puskyer/Fixture-Dev-Kit/HARDWARE/MOSFET-NOTE/P-ChannelMosfetCircuit.jpg

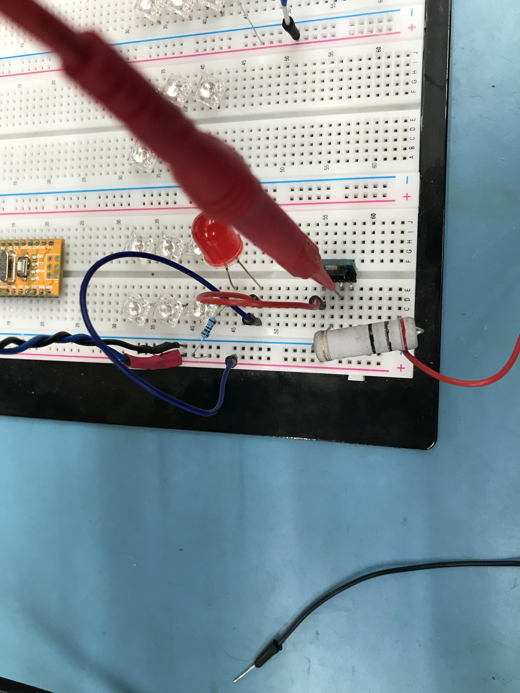
HARDWARE/MOSFET-NOTE/P-ChannelMosfetCircuit.jpg
