puskyer/Fixture-Dev-Kit/HARDWARE/MOSFET-NOTE/N-ChannelMosfetCircuit.jpg

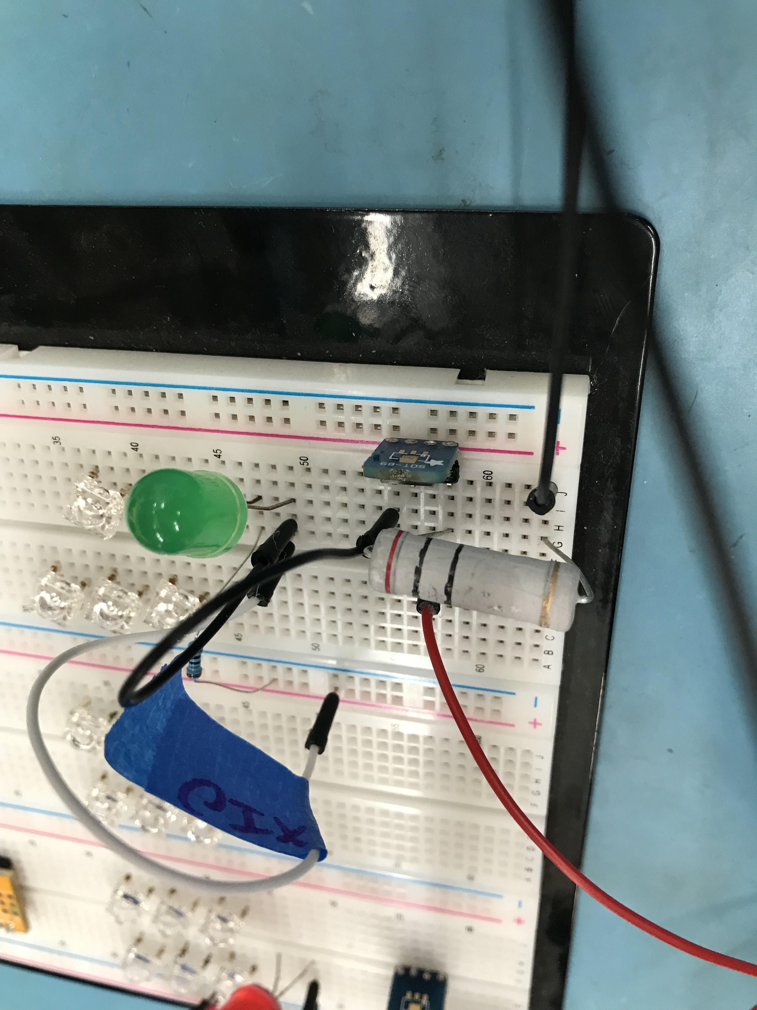
HARDWARE/MOSFET-NOTE/N-ChannelMosfetCircuit.jpg
