puskyer/Fixture-Dev-Kit/README.md

# Fixture-Dev-Kit
A PCB for test fixture prototyping
