puskyer/Fixture-Dev-Kit/HARDWARE/Fixture-Dev-Kit-v0.02/DATASHEETS/YSS-19-1202-N.jpg

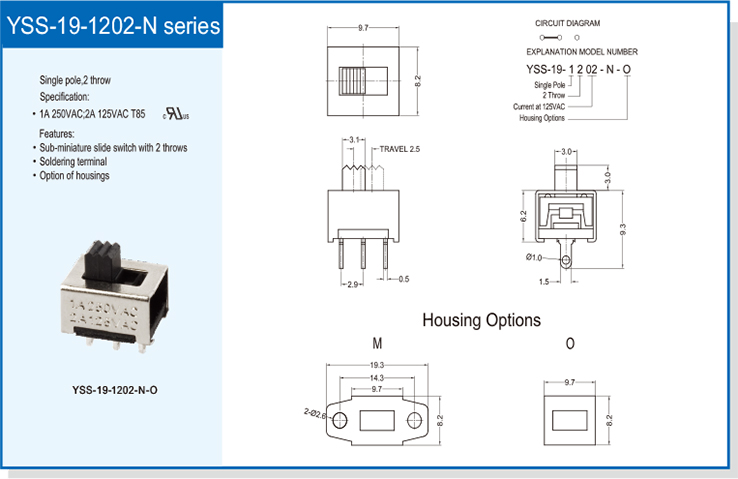
HARDWARE/Fixture-Dev-Kit-v0.02/DATASHEETS/YSS-19-1202-N.jpg
