puskyer/Fixture-Dev-Kit/HARDWARE/MOSFET-NOTE/MOSFET-P+N-Circuits.jpg

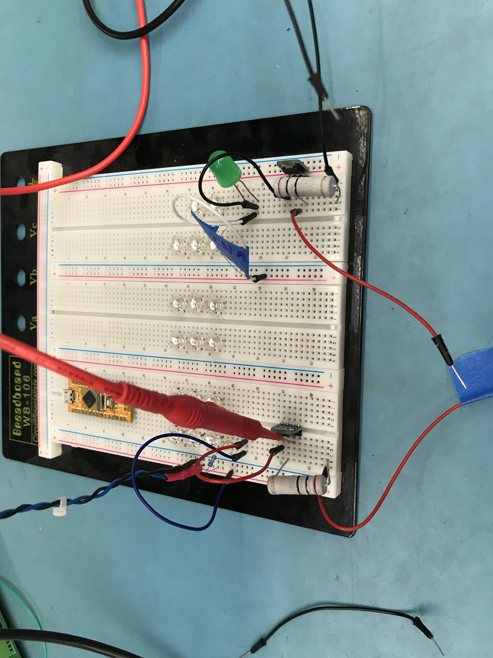
HARDWARE/MOSFET-NOTE/MOSFET-P+N-Circuits.jpg
