puskyer/Fixture-Dev-Kit/HARDWARE/CHIP4_DUT_Adapter_Board_PCB/Fixture-Dev-Kit-C4-Adapater-Board.SLDPRT

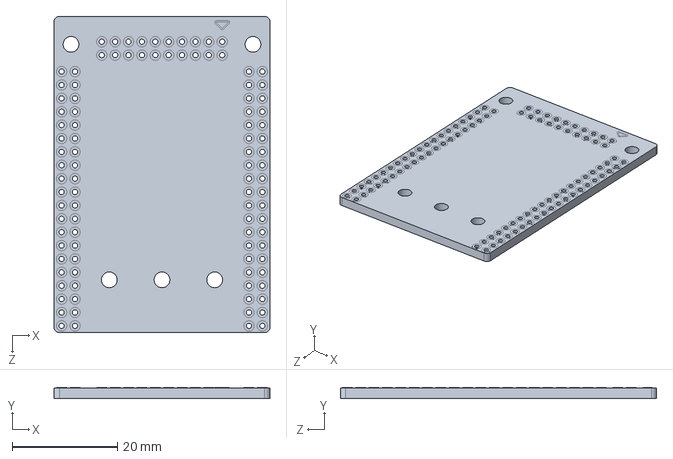
[picture p8: CAD file, 2017-11-10]
HARDWARE/CHIP4_DUT_Adapter_Board_PCB/Fixture-Dev-Kit-C4-Adapater-Board.SLDPRT
41.0 x 2.01 x 60.0 mm
