puskyer/Fixture-Dev-Kit/HARDWARE/CHIP4_DUT_Adapter_Board_PCB/KiCad/v0.02/Fixture-Dev-Kit-C4-Adapater-Board-PCB/3d_models/PUQFN-N32_5mmX5mm_P0.5.step

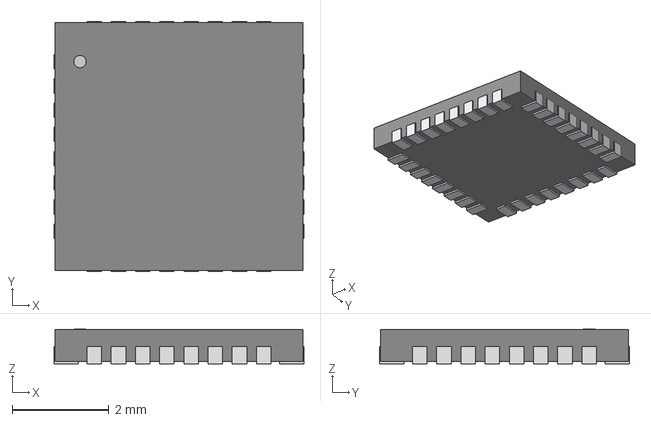
[picture p9: CAD file, 2017-11-21]
HARDWARE/CHIP4_DUT_Adapter_Board_PCB/KiCad/v0.02/Fixture-Dev-Kit-C4-Adapater-Board-PCB/3d_models/PUQFN-N32_5mmX5mm_P0.5.step
5.16 x 5.16 x 0.714 mm
