puskyer/Fixture-Dev-Kit/(list of files, cad)

Other CAD files:
HARDWARE/CHIP4_DUT_Adapter_Board_PCB/Fixture-Dev-Kit-C4-Adapater-Board.SLDDRW
