puskyer/Fixture-Dev-Kit/HARDWARE/CHIP4_DUT_Adapter_Board_PCB/KiCad/v0.02/Fixture-Dev-Kit-C4-Adapater-Board-PCB/pdf/Fixture-Dev-Kit-C4-Adapater-Board.PDF

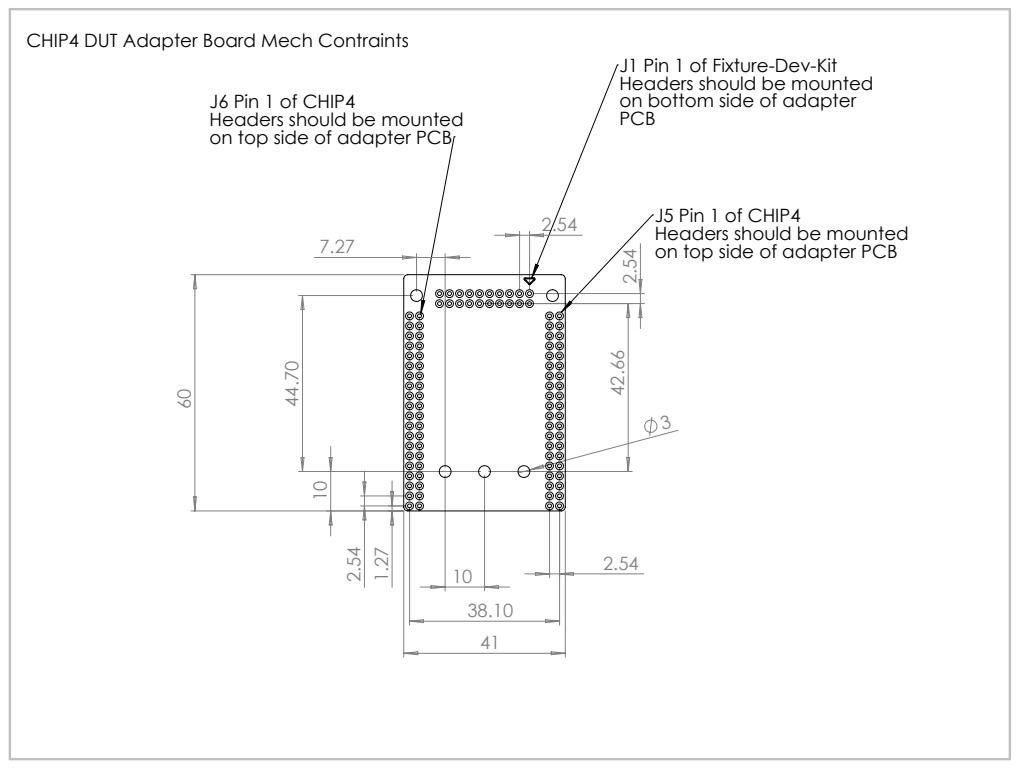
[picture p10: page 1]

CHIP4 DUT Adapter Board Mech Contraints

J1 Pin 1 of Fixture-Dev-Kit
Headers should be mounted
on bottom side of adapter
PCB

J6 Pin 1 of CHIP4
on top side of adapter PCB

J5 Pin 1 of CHIP4
