puskyer/Fixture-Dev-Kit/HARDWARE/MOSFET-NOTE/file5A05F538-Sheet5A05F538.pdf

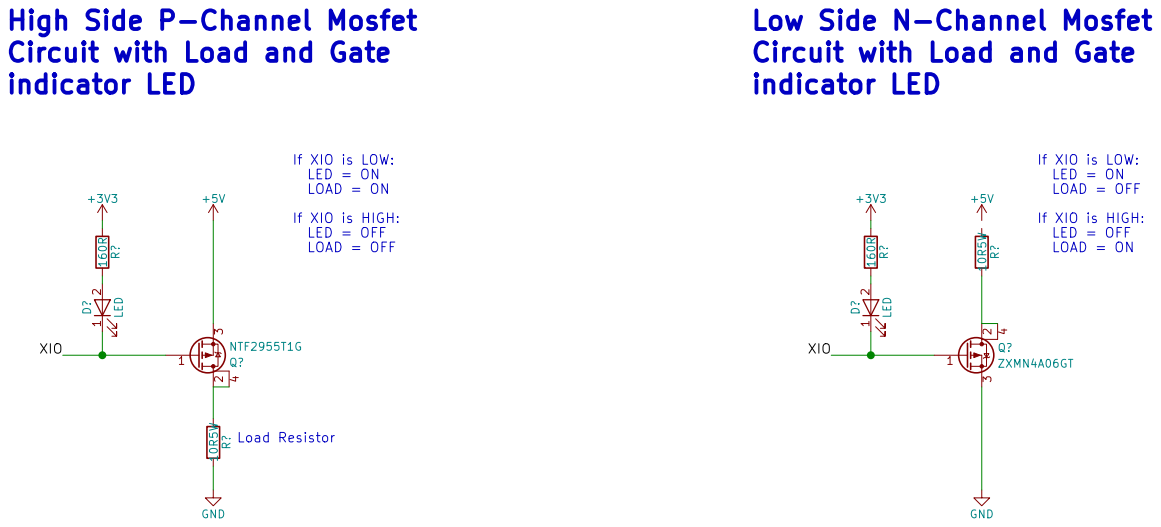
[picture p11: page 1]
