puskyer/Fixture-Dev-Kit/HARDWARE/v0.05/KiCad/pdf/Bottom_Cu_Layers.pdf

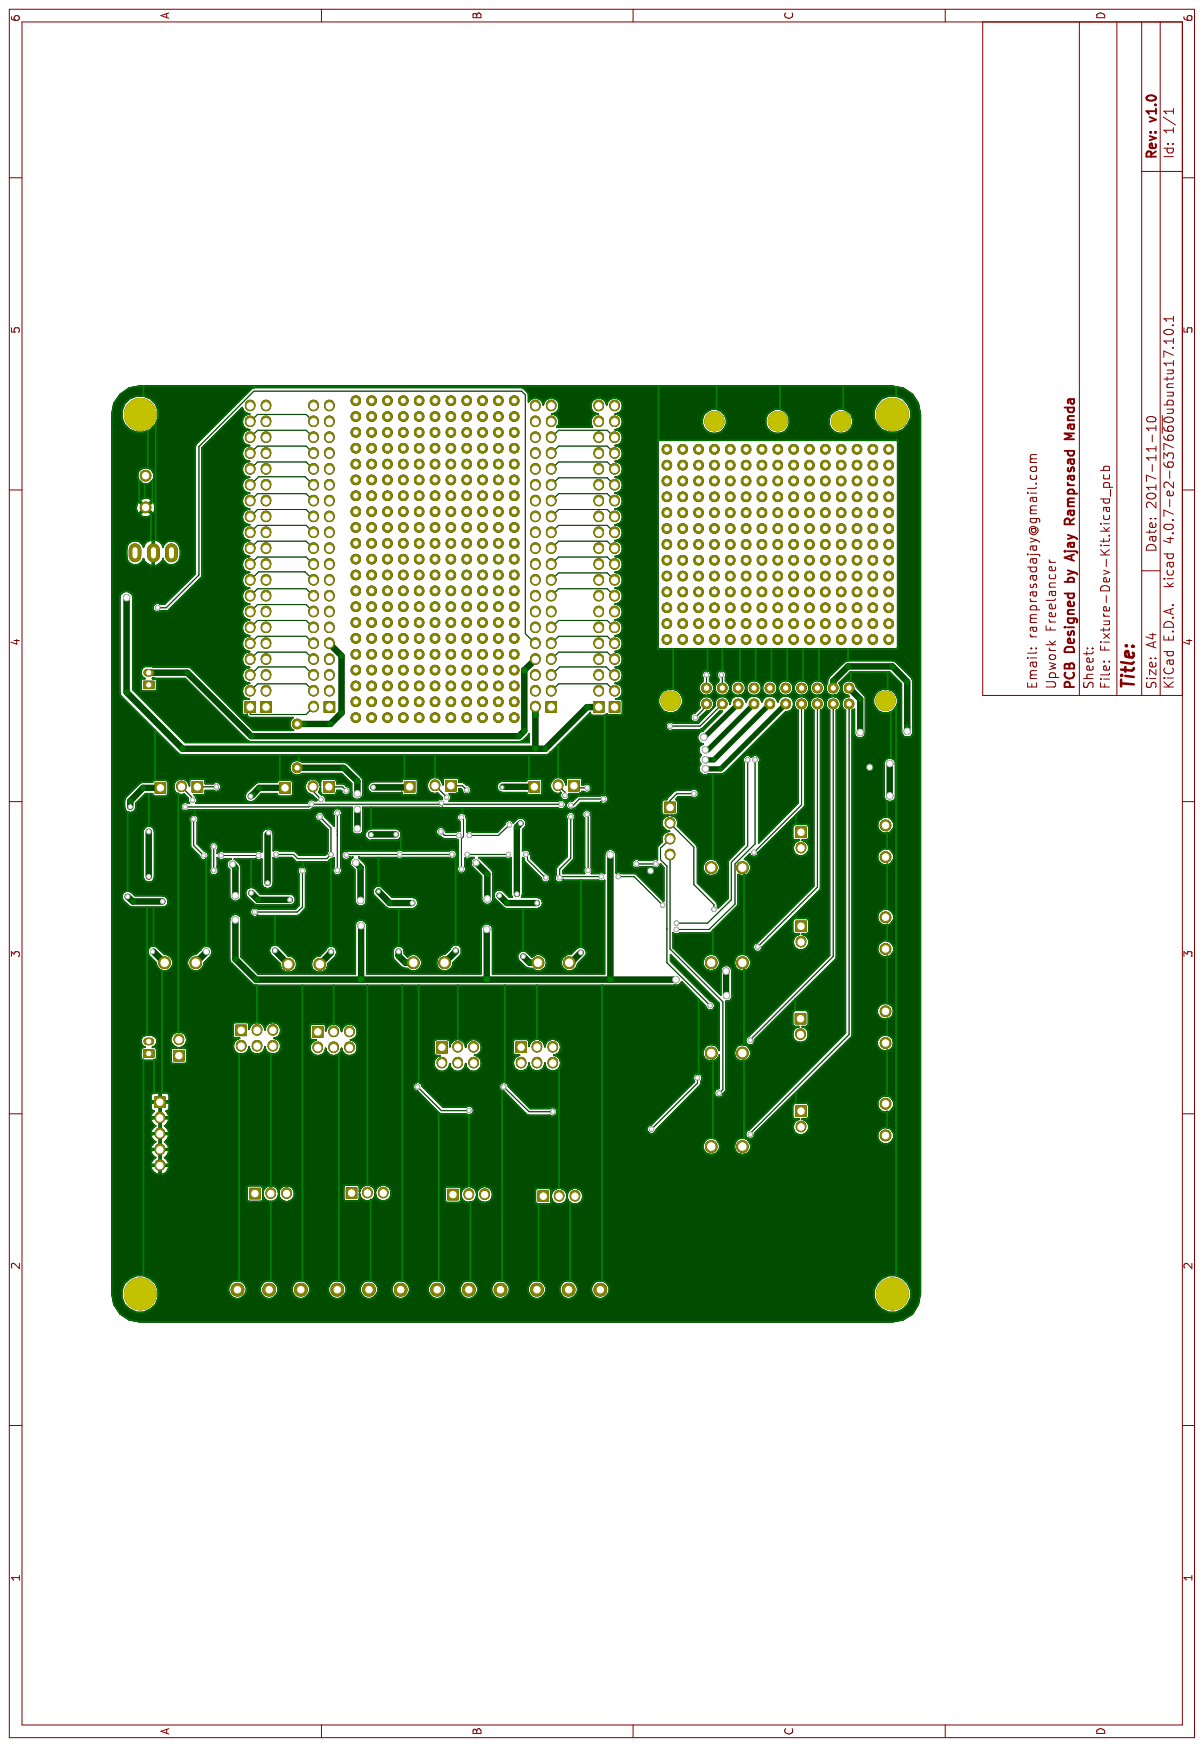
[picture p12: page 1]

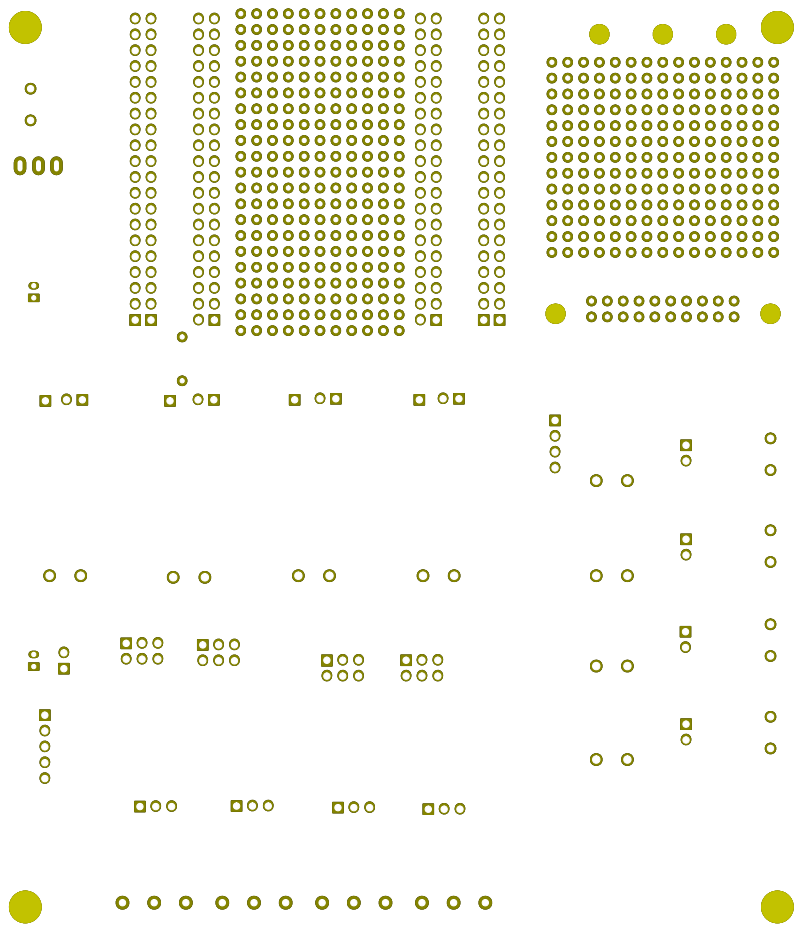
[picture p13: page 2]

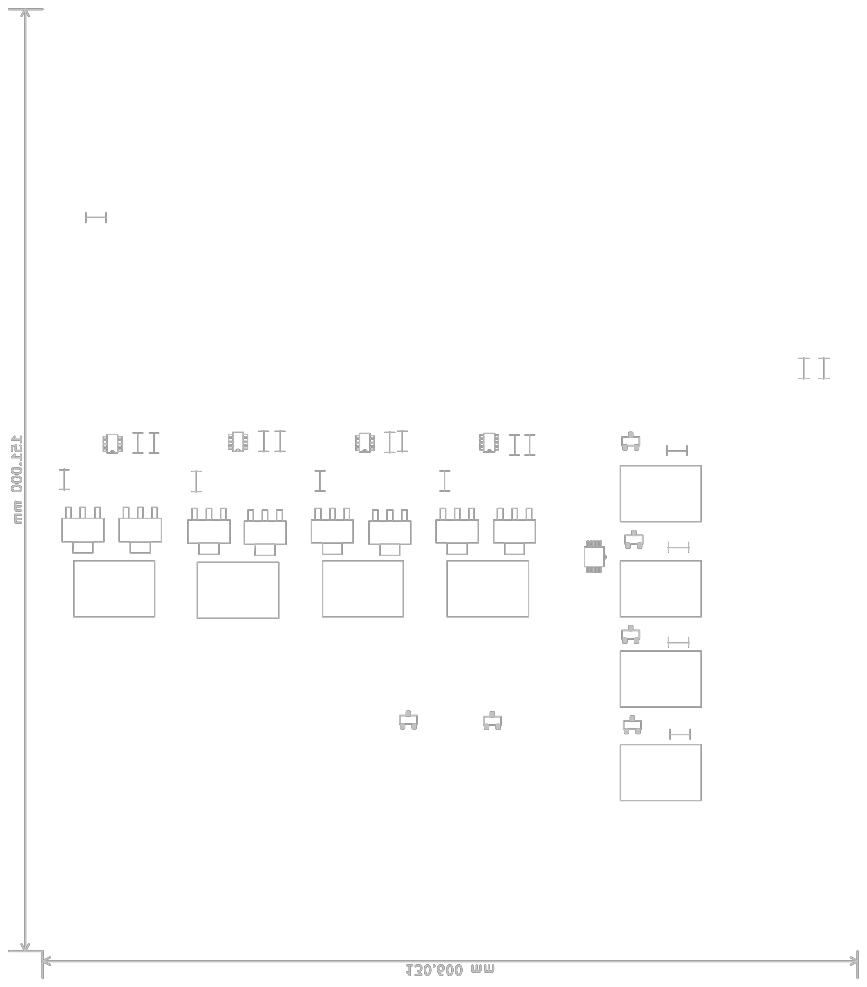
[picture p14: page 3]

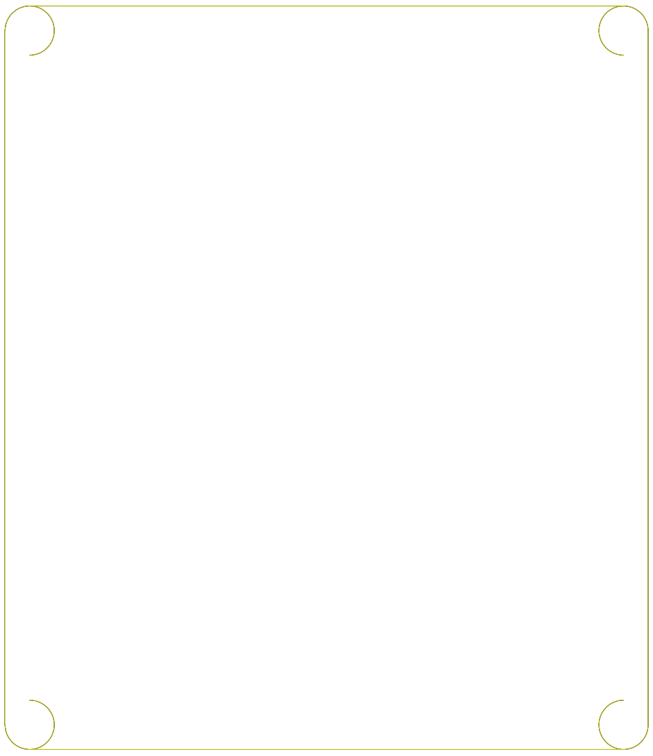
[picture p15: figure]
