puskyer/Fixture-Dev-Kit/HARDWARE/v0.05/KiCad/pdf/Front_Cu_Layers.pdf

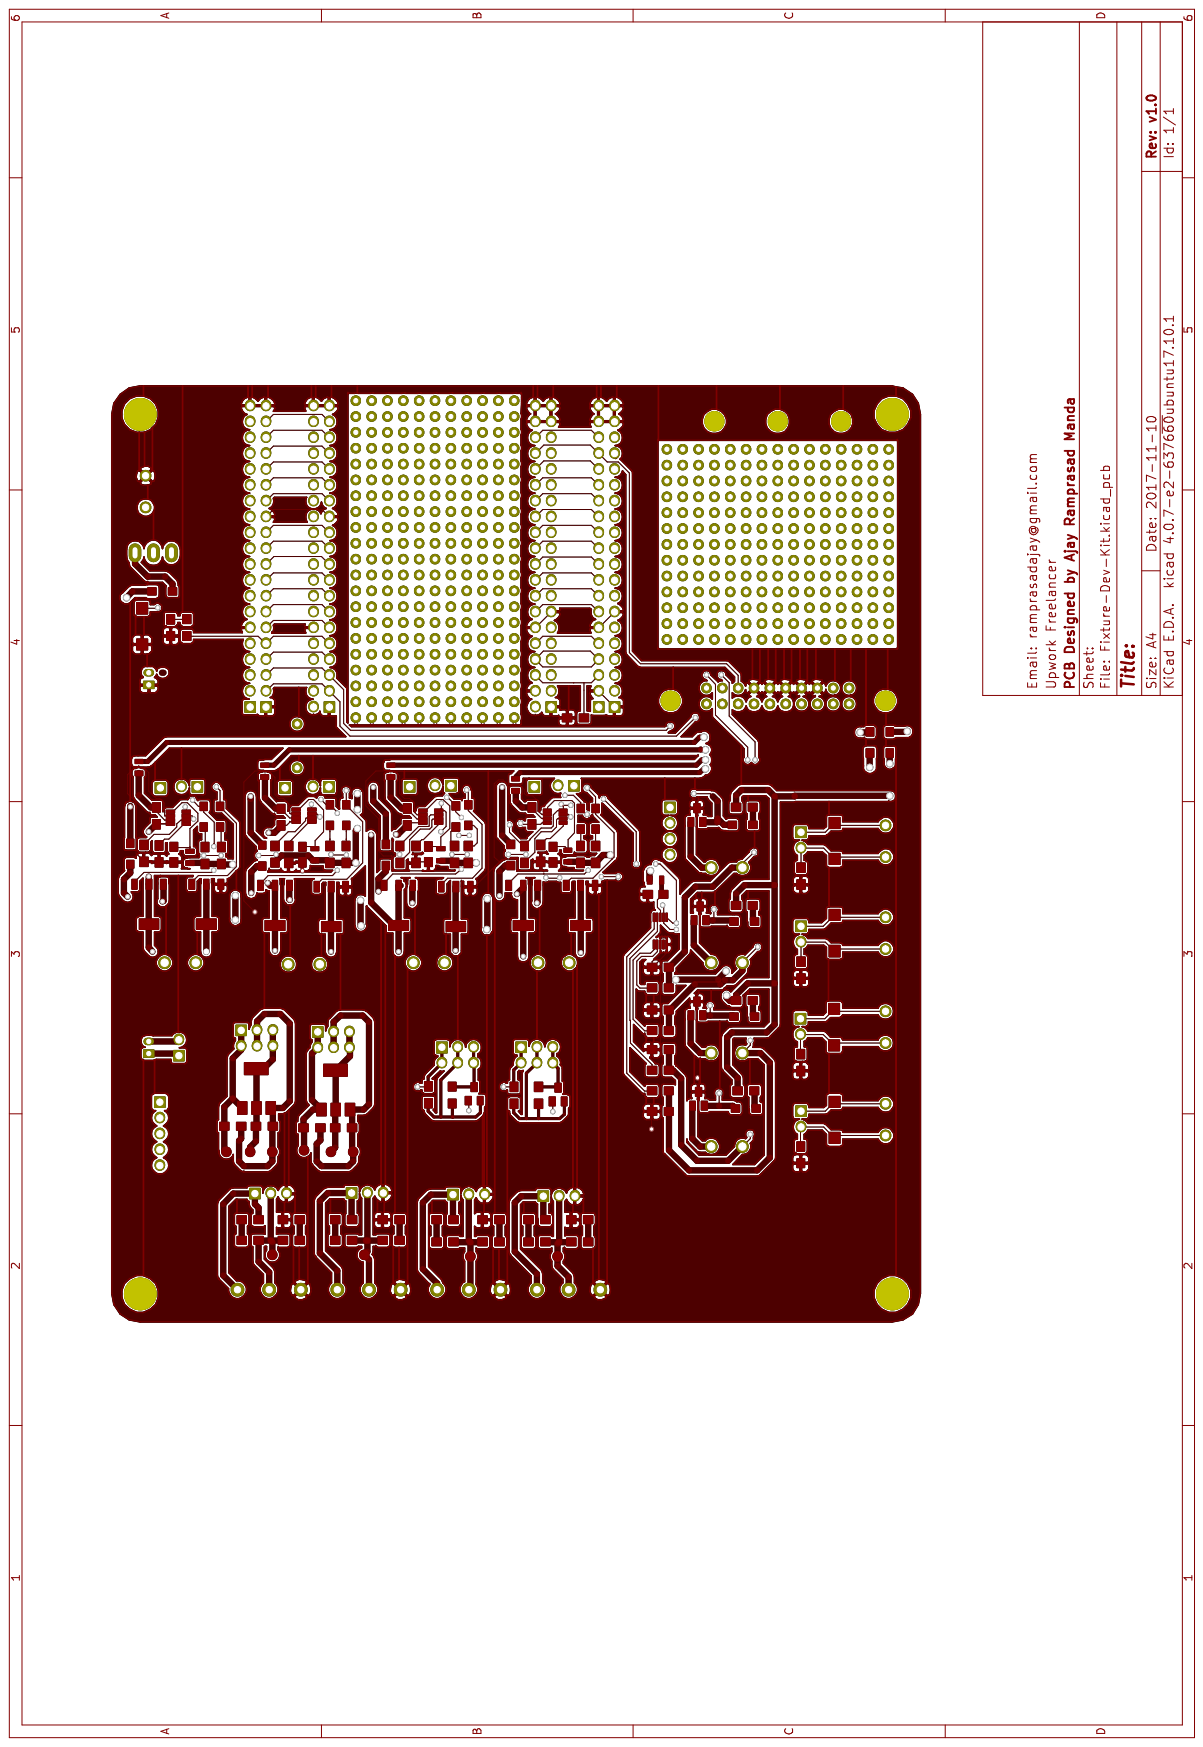
[picture p16: page 1]

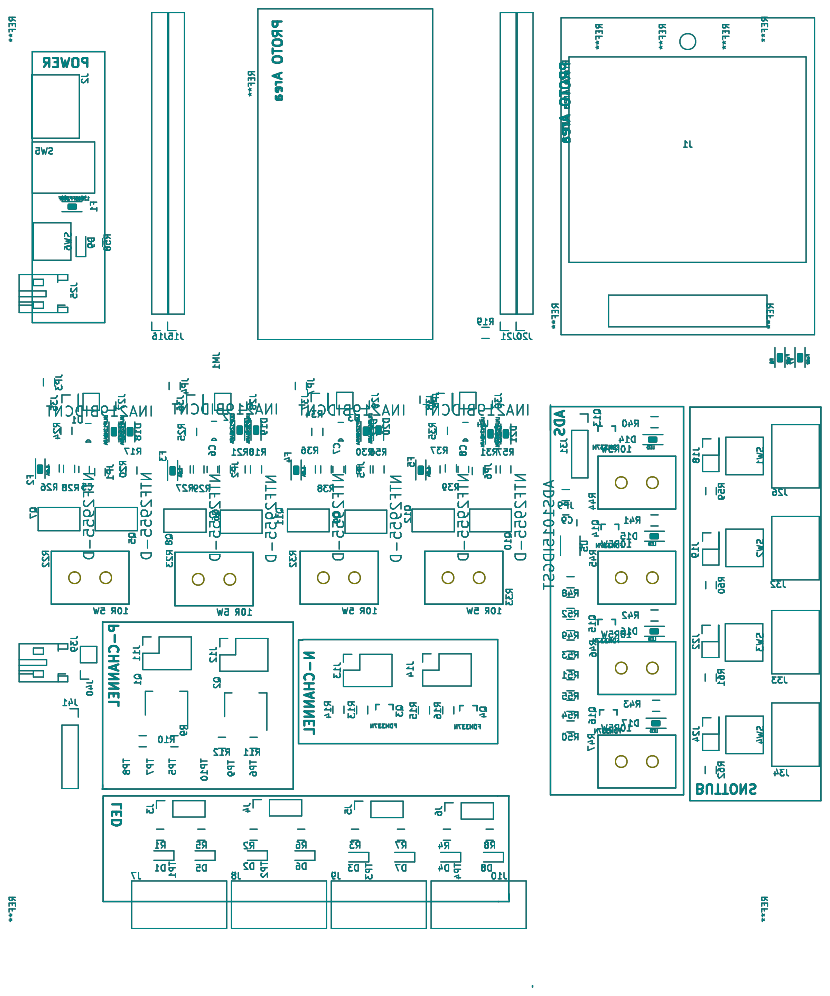
[picture p17: page 2]

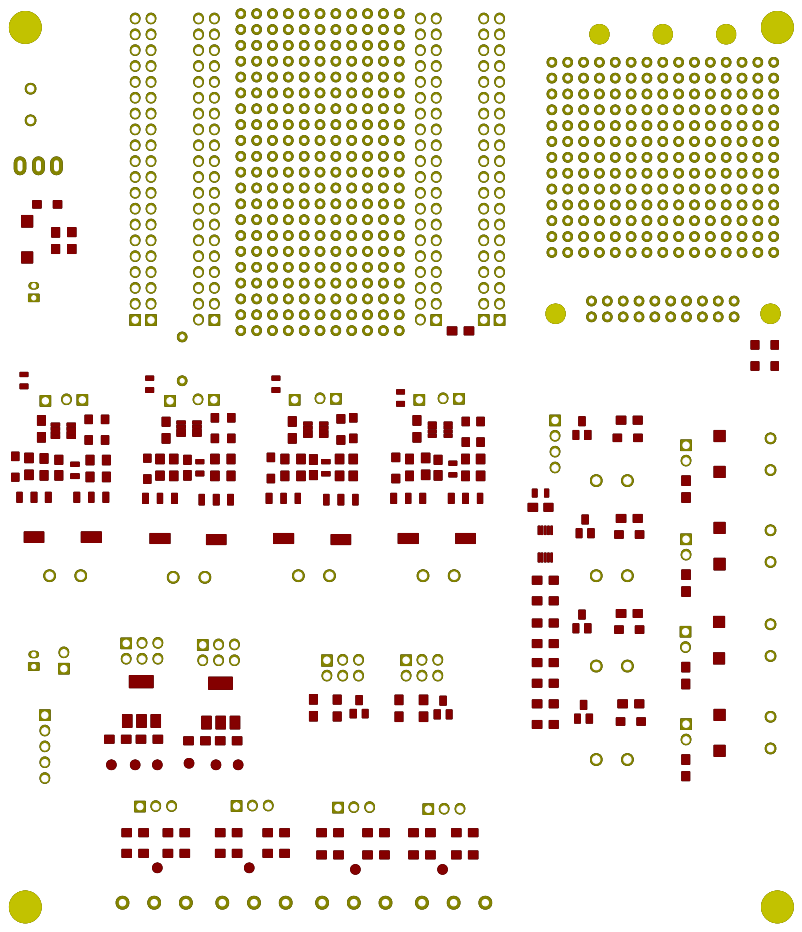
[picture p18: page 3]


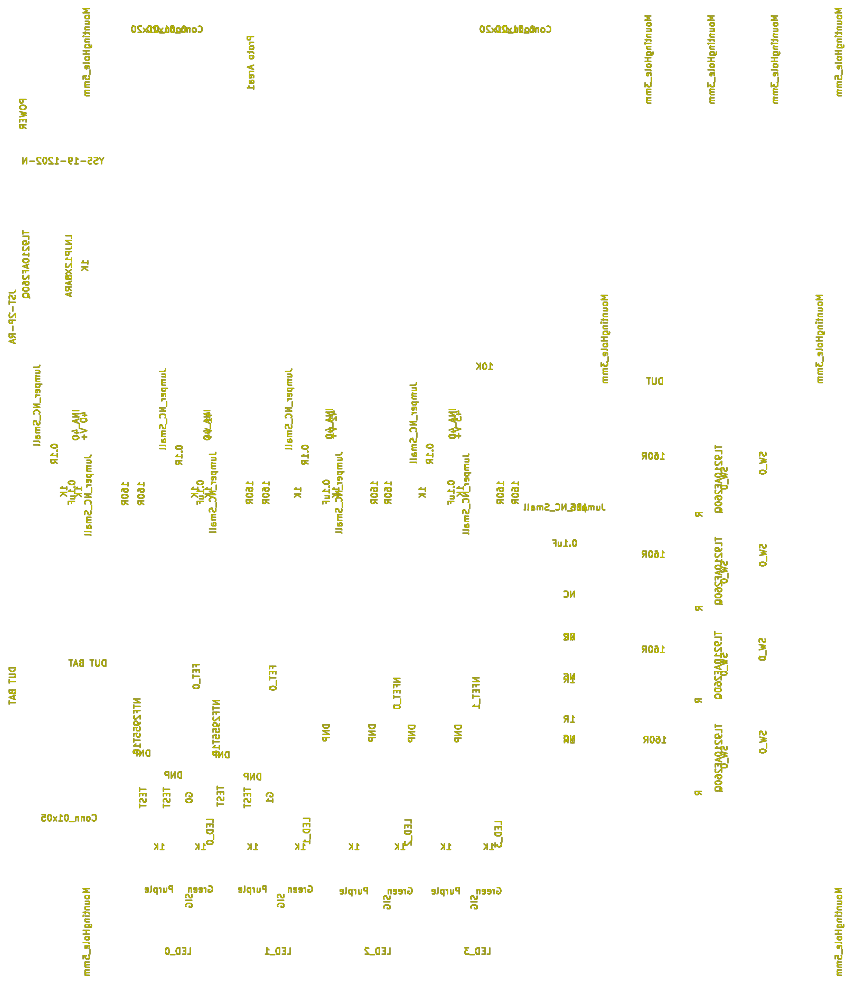
[picture p19: page 6]
