puskyer/Fixture-Dev-Kit/HARDWARE/v0.02/KiCad/Gerber/Fixture-Dev-Kit-B.Cu.pdf

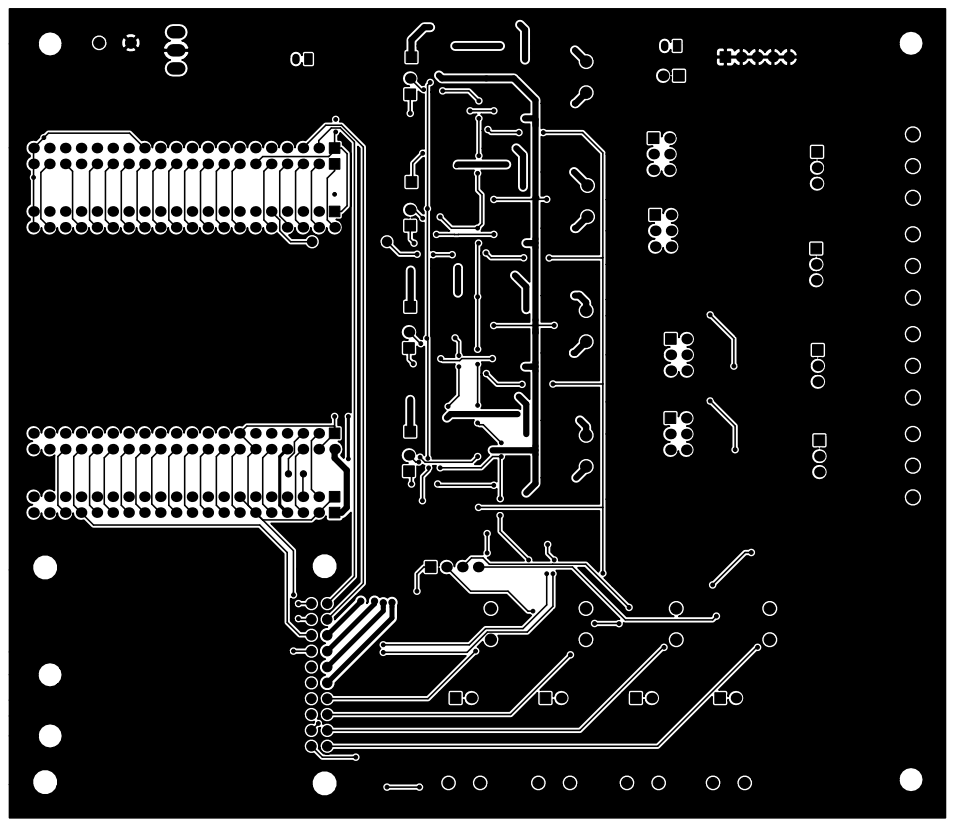
[picture p30: page 1]
