puskyer/Fixture-Dev-Kit/HARDWARE/v0.02/KiCad/Gerber/Fixture-Dev-Kit-Edge.Cuts.pdf

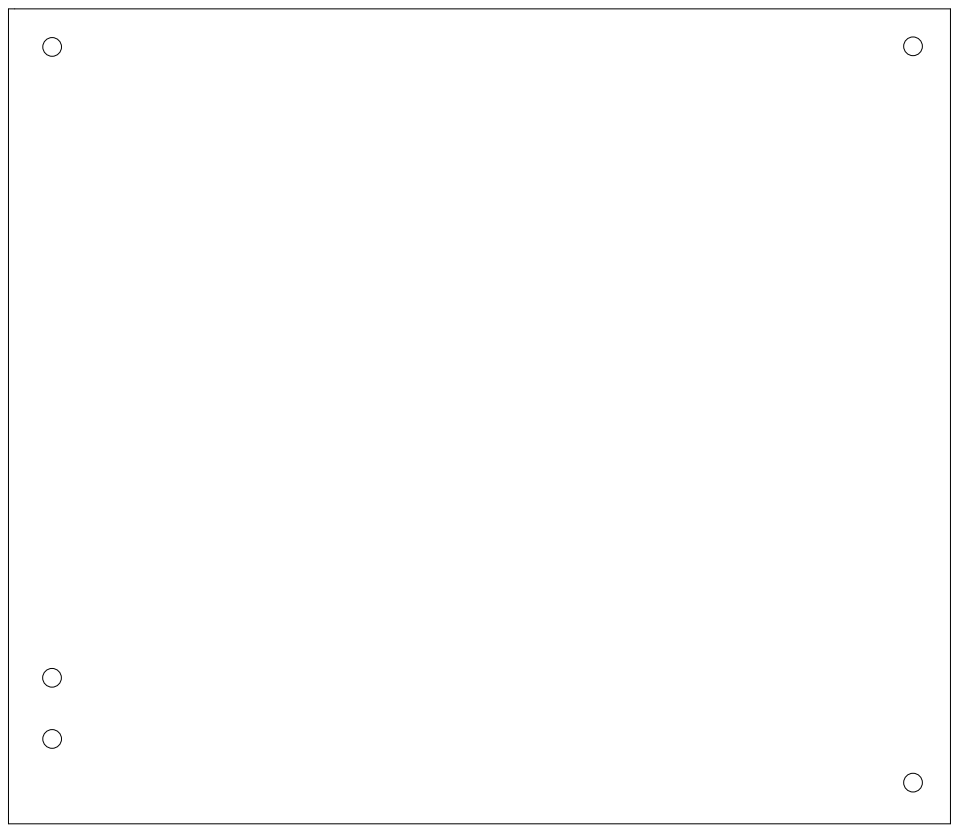
[picture p31: page 1]
