puskyer/Fixture-Dev-Kit/HARDWARE/v0.02/KiCad/Gerber/Fixture-Dev-Kit-F.Cu.pdf

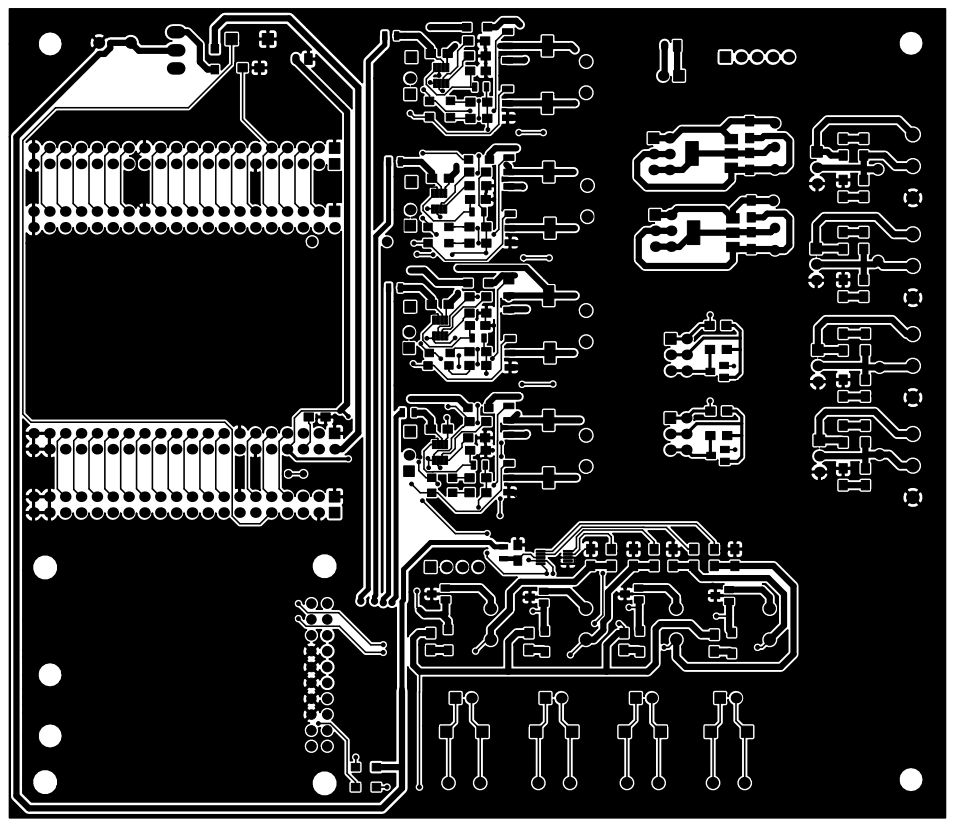
[picture p32: page 1]
