puskyer/Fixture-Dev-Kit/HARDWARE/v0.02/KiCad/Gerber/Fixture-Dev-Kit-F.Mask.pdf

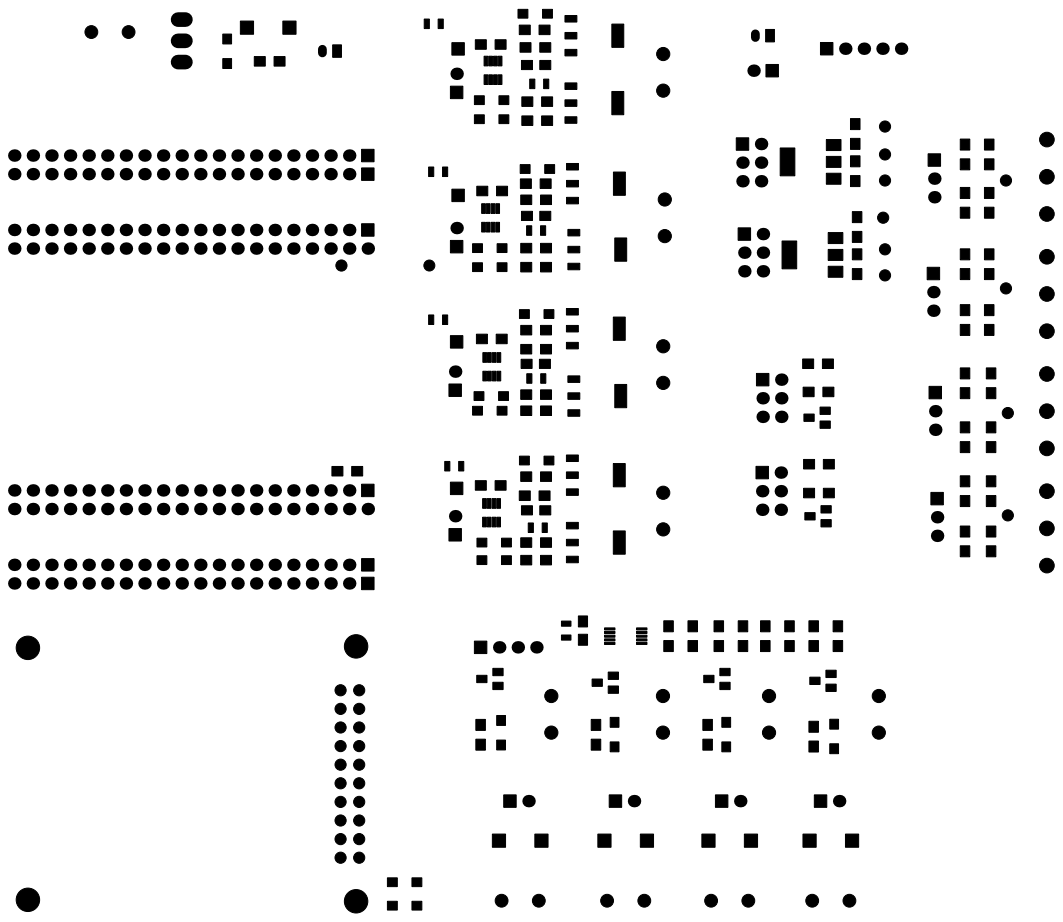
[picture p33: page 1]
