puskyer/Fixture-Dev-Kit/HARDWARE/v0.02/KiCad/Gerber/Fixture-Dev-Kit-F.Paste.pdf

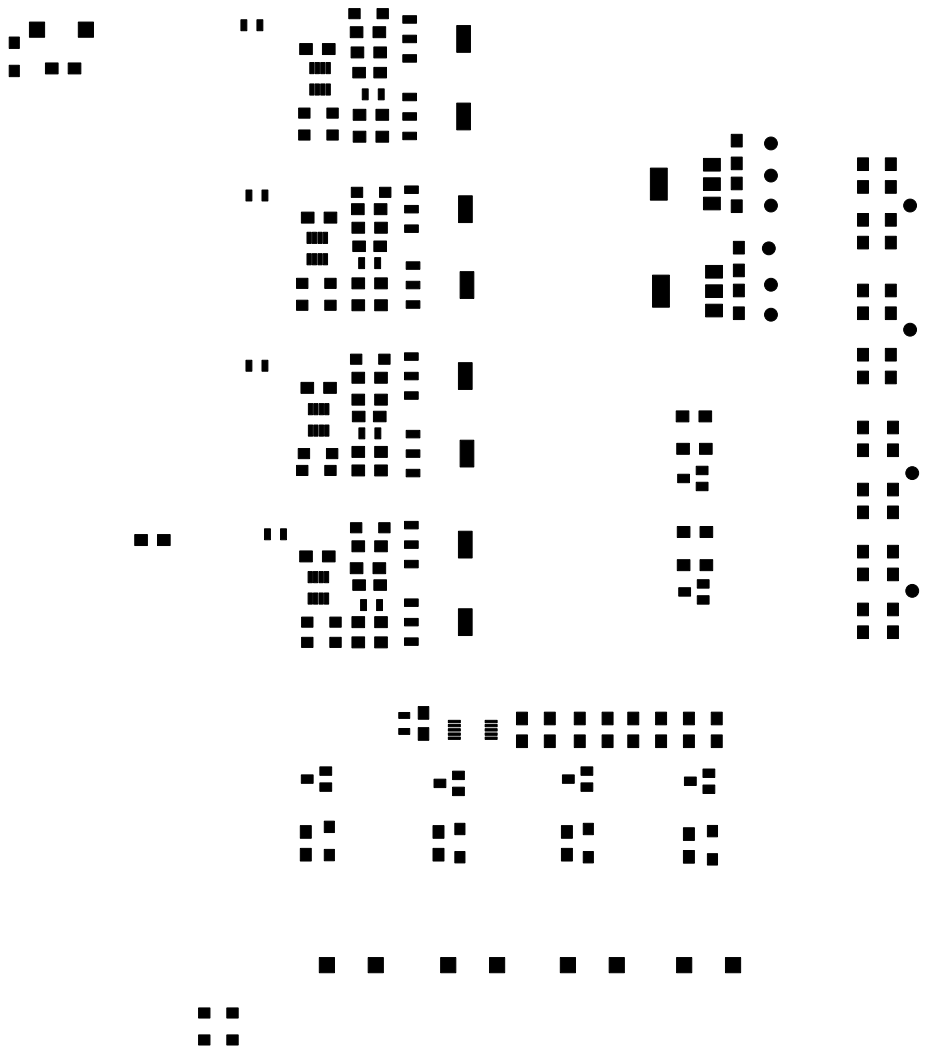
[picture p34: page 1]
