puskyer/Fixture-Dev-Kit/HARDWARE/v0.04/KiCad/Fixture-Dev-Kit.kicad_pcb

## KiCad design HARDWARE/v0.04/KiCad/Fixture-Dev-Kit.kicad_pcb (2017-11-10, an earlier design)

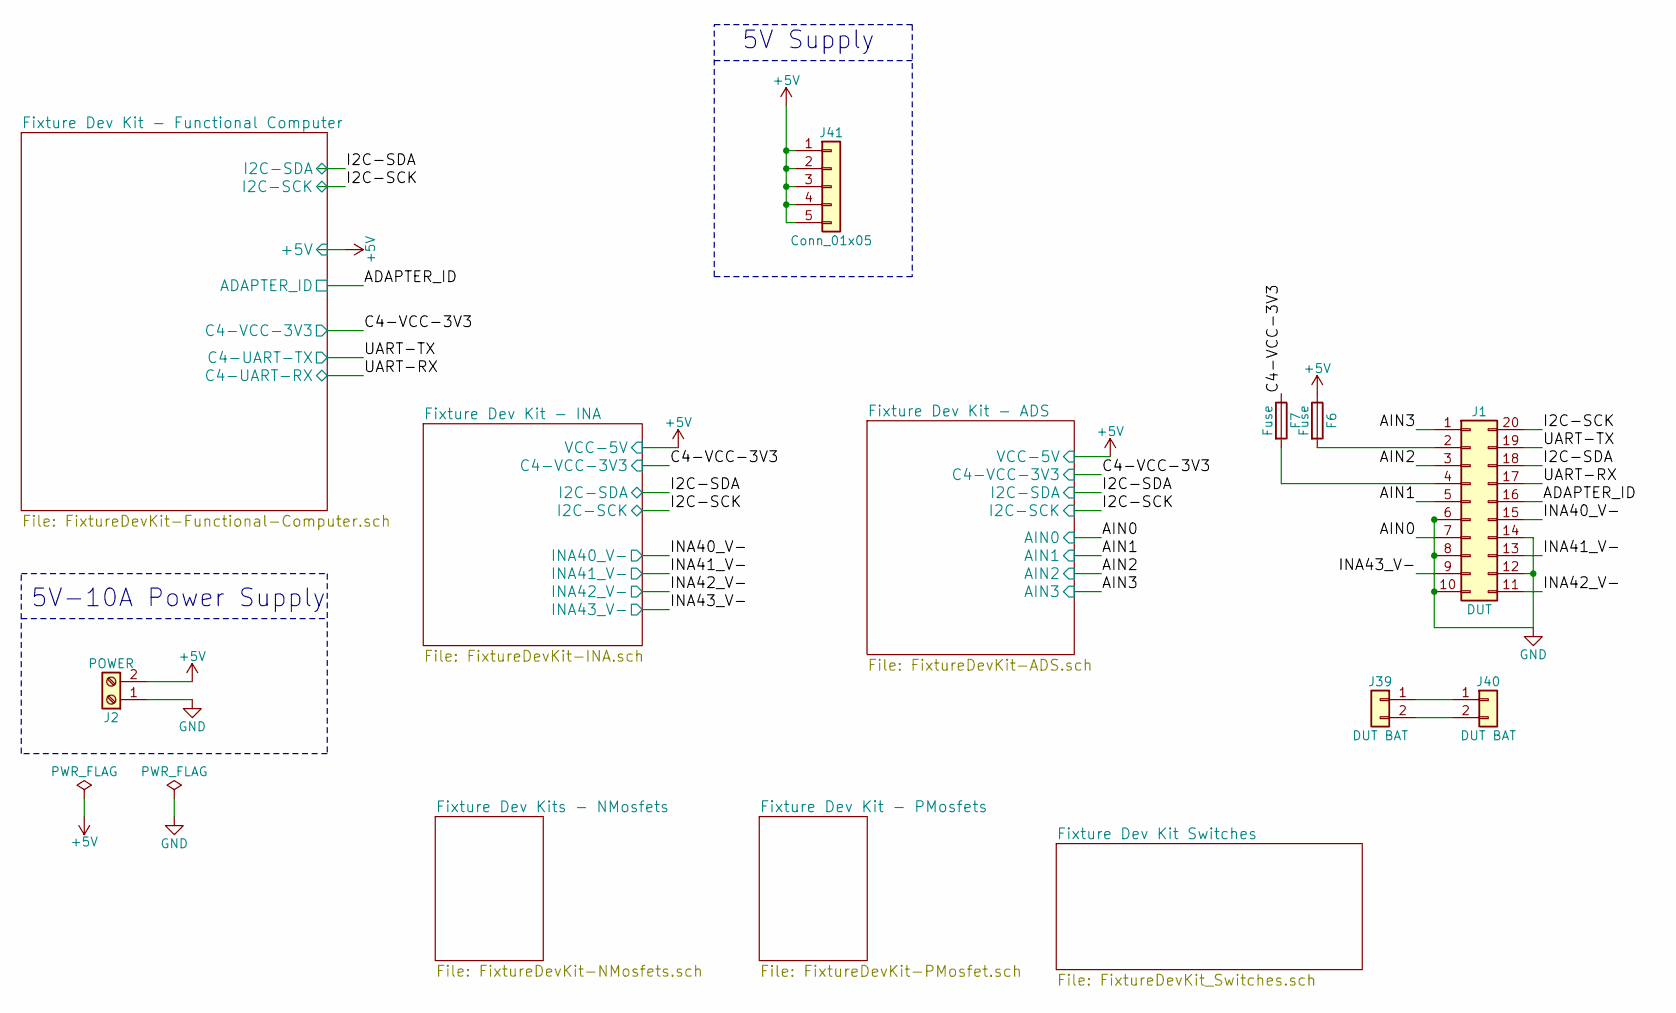
[picture p36: schematic Fixture-Dev-Kit.sch]

Parts:
F6, F7: Fuse; 1206
J1: DUT; DUT_HEADER_FOOTPRINT
J2: POWER; 2Pin5.08
J39: DUT BAT; JST_PH_S2B-PH-K_02x2.00mm_Angled
J40: DUT BAT; Pin_Header_Straight_1x02_Pitch2.54mm
J41: Conn_01x05; Pin_Header_Angled_1x05_Pitch2.54mm

Connections:
+5V: F6.1, J2.2, J41.1, J41.2, J41.3, J41.4, J41.5; also elsewhere on the board
/ADAPTER_ID: J1.16; also elsewhere on the board
/AIN0: J1.7; also elsewhere on the board
/AIN1: J1.5; also elsewhere on the board
/AIN2: J1.3; also elsewhere on the board
/AIN3: J1.1; also elsewhere on the board
/C4-VCC-3V3: F7.1; also elsewhere on the board
/I2C-SCK: J1.20; also elsewhere on the board
/I2C-SDA: J1.18; also elsewhere on the board
/INA40_V-: J1.15; also elsewhere on the board
/INA41_V-: J1.13; also elsewhere on the board
/INA42_V-: J1.11; also elsewhere on the board
/INA43_V-: J1.9; also elsewhere on the board
/UART-RX: J1.17; also elsewhere on the board
/UART-TX: J1.19; also elsewhere on the board
unnamed: F6.2, J1.2
unnamed: F7.2, J1.4
unnamed: J39.1, J40.1
unnamed: J39.2, J40.2

Notes on the sheet:
5V-10A Power Supply
5V Supply

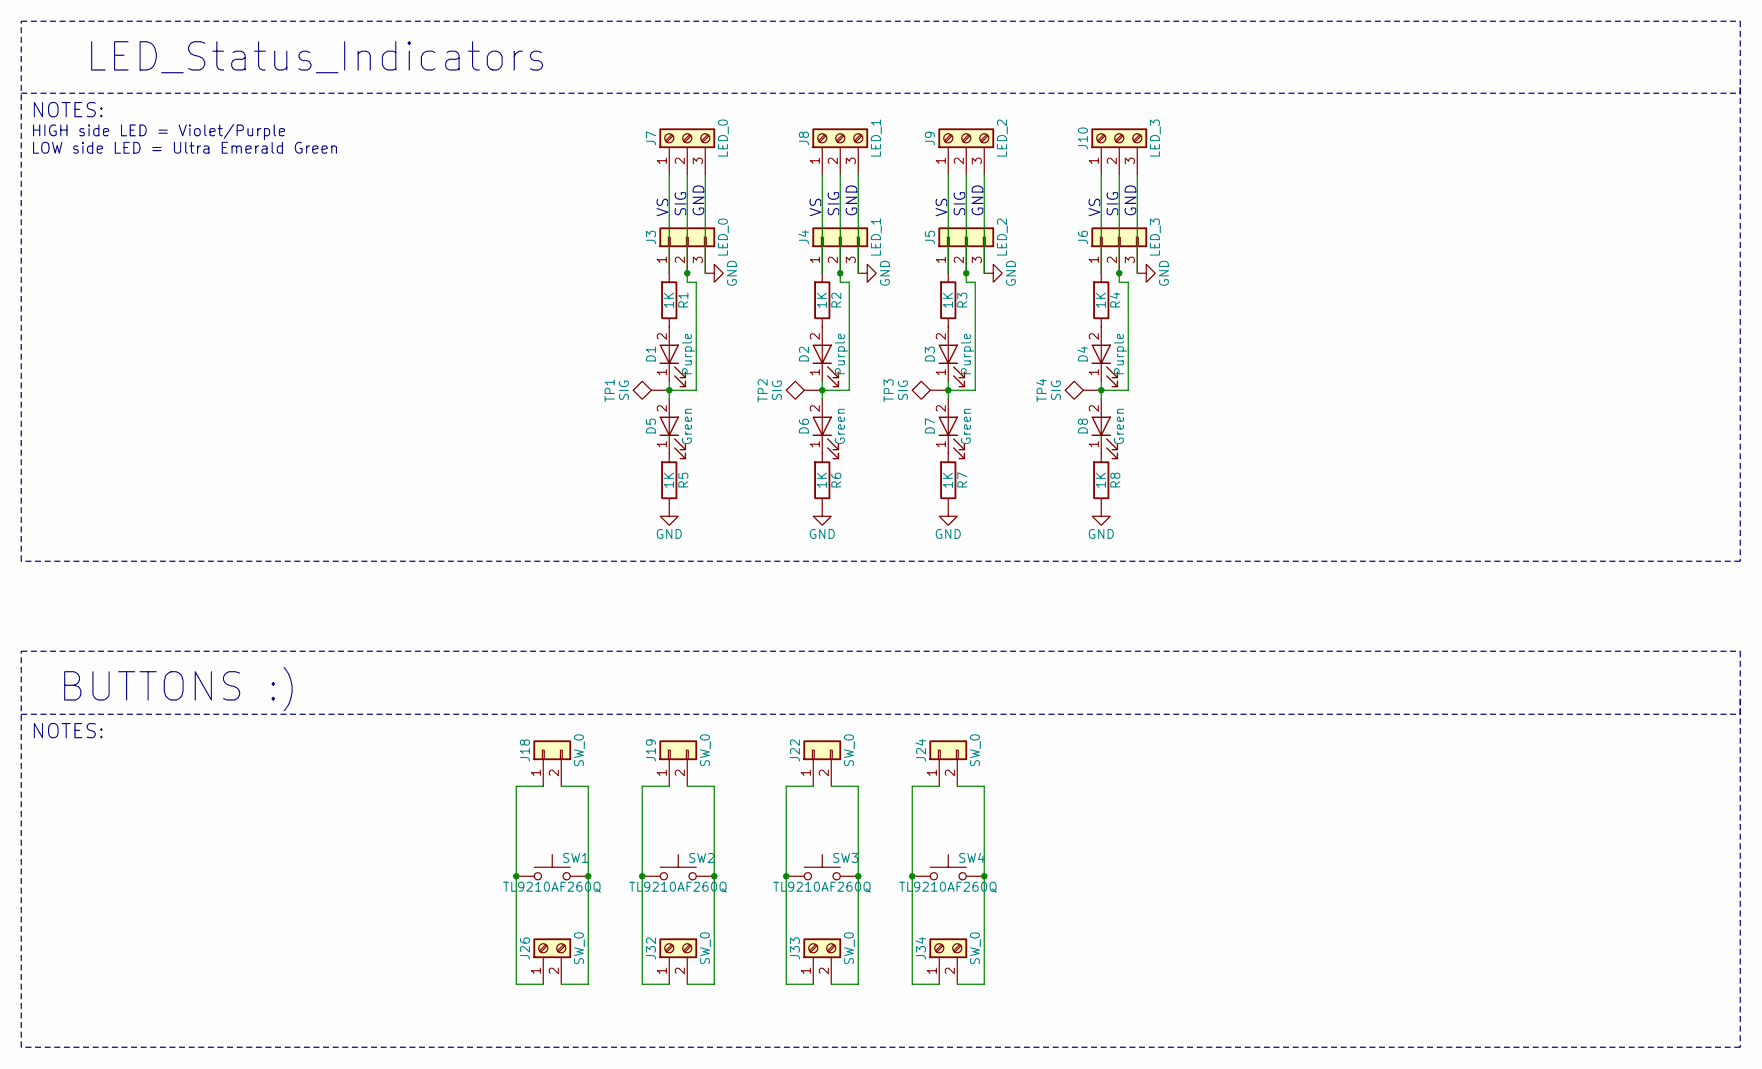
[picture p37: schematic FixtureDevKit_Switches.sch, Fixture-Dev-Kit]

Parts:
D1, D2, D3, D4: Purple; LED_0805_HandSoldering
D5, D6, D7, D8: Green; LED_0805_HandSoldering
J3: LED_0; Pin_Header_Straight_1x03_Pitch2.54mm
J4: LED_1; Pin_Header_Straight_1x03_Pitch2.54mm
J5: LED_2; Pin_Header_Straight_1x03_Pitch2.54mm
J6: LED_3; Pin_Header_Straight_1x03_Pitch2.54mm
J7: LED_0; 3Pin5.08
J8: LED_1; 3Pin5.08
J9: LED_2; 3Pin5.08
J10: LED_3; 3Pin5.08
J18, J19, J22, J24: SW_0; Pin_Header_Straight_2x01_Pitch2.54mm
J26, J32, J33, J34: SW_0; 2Pin5.08
R1, R2, R3, R4, R5, R6, R7, R8: 1K; R_0805_HandSoldering
SW1, SW2, SW3, SW4: TL9210AF260Q
TP1, TP2, TP3, TP4: SIG; TestPoint

Connections:
unnamed: D1.1 (K), D5.2 (A), J3.2, J7.2, TP1.1
unnamed: D1.2 (A), R1.1
unnamed: D2.1 (K), D6.2 (A), J4.2, J8.2, TP2.1
unnamed: D2.2 (A), R2.1
unnamed: D3.1 (K), D7.2 (A), J5.2, J9.2, TP3.1
unnamed: D3.2 (A), R3.1
unnamed: D4.1 (K), D8.2 (A), J6.2, J10.2, TP4.1
unnamed: D4.2 (A), R4.1
unnamed: D5.1 (K), R5.2
unnamed: D6.1 (K), R6.2
unnamed: D7.1 (K), R7.2
unnamed: D8.1 (K), R8.2
unnamed: J3.1, J7.1, R1.2
unnamed: J4.1, J8.1, R2.2
unnamed: J5.1, J9.1, R3.2
unnamed: J6.1, J10.1, R4.2
unnamed: J18.1, J26.1, SW1.1
unnamed: J18.2, J26.2, SW1.2
unnamed: J19.1, J32.1, SW2.1
unnamed: J19.2, J32.2, SW2.2
unnamed: J22.1, J33.1, SW3.1
unnamed: J22.2, J33.2, SW3.2
unnamed: J24.1, J34.1, SW4.1
unnamed: J24.2, J34.2, SW4.2

Notes on the sheet:
GND
SIG
LED_Status_Indicators
BUTTONS :)
HIGH side LED = Violet/Purple LOW side LED = Ultra Emerald Green
NOTES:

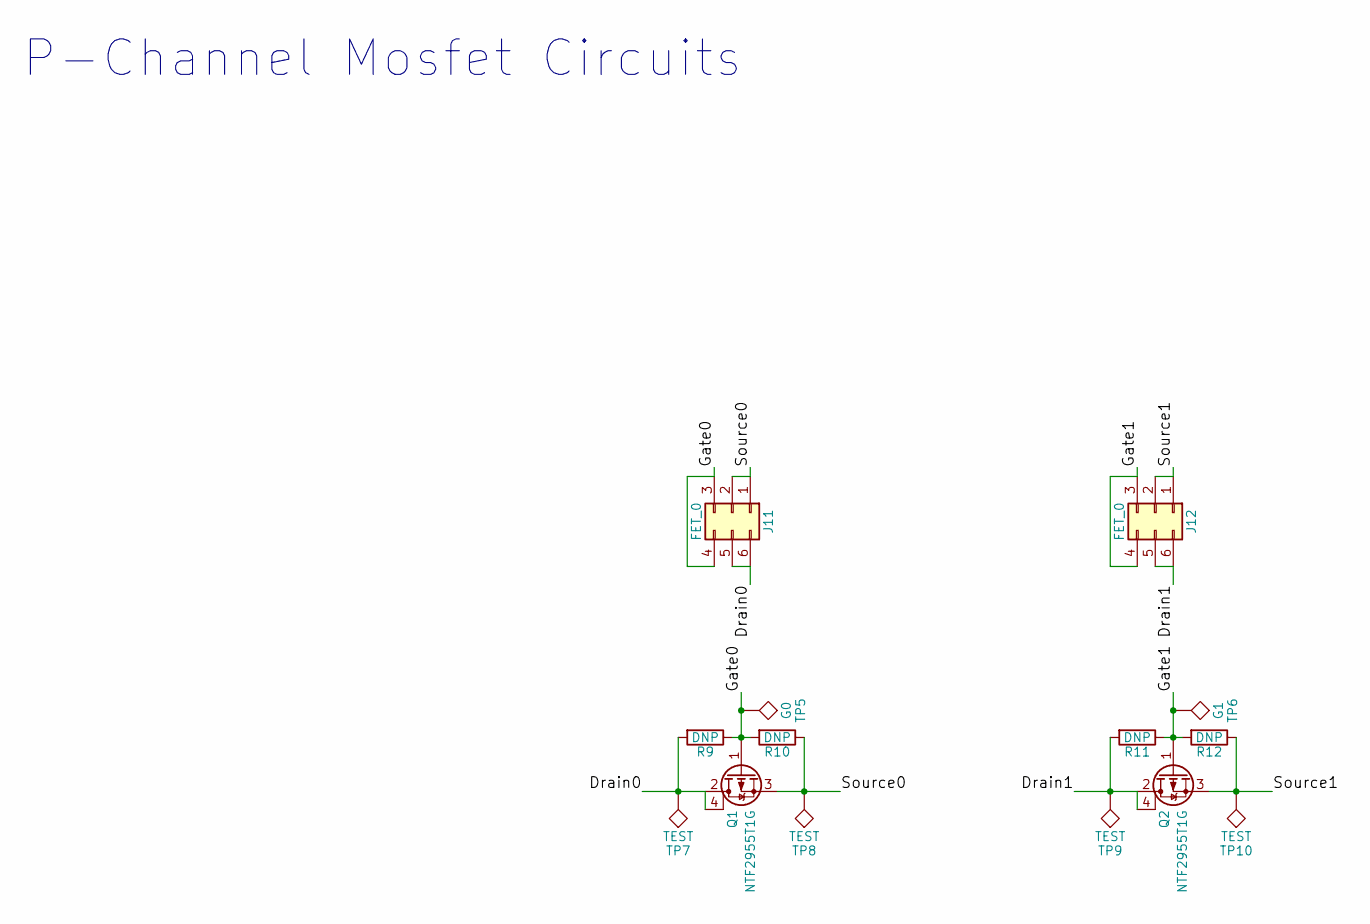
[picture p38: schematic FixtureDevKit-PMosfet.sch, Fixture-Dev-Kit]

Parts:
J11, J12: FET_0; Pin_Header_Straight_2x03_Pitch2.54mm
Q1, Q2: NTF2955T1G; SOT-223
R9, R10, R11, R12: DNP; R_0805_HandSoldering
TP5: G0; TestPoint
TP6: G1; TestPoint
TP7, TP8, TP9, TP10: TEST; TestPoint

Connections:
/Fixture Dev Kit - PMosfets/Drain0: J11.5, J11.6, Q1.2 (D), Q1.4 (D), R9.2, TP7.1
/Fixture Dev Kit - PMosfets/Drain1: J12.5, J12.6, Q2.2 (D), Q2.4 (D), R11.2, TP9.1
/Fixture Dev Kit - PMosfets/Gate0: J11.3, J11.4, Q1.1 (G), R9.1, R10.2, TP5.1
/Fixture Dev Kit - PMosfets/Gate1: J12.3, J12.4, Q2.1 (G), R11.1, R12.2, TP6.1
/Fixture Dev Kit - PMosfets/Source0: J11.1, J11.2, Q1.3 (S), R10.1, TP8.1
/Fixture Dev Kit - PMosfets/Source1: J12.1, J12.2, Q2.3 (S), R12.1, TP10.1

Notes on the sheet:
P-Channel Mosfet Circuits

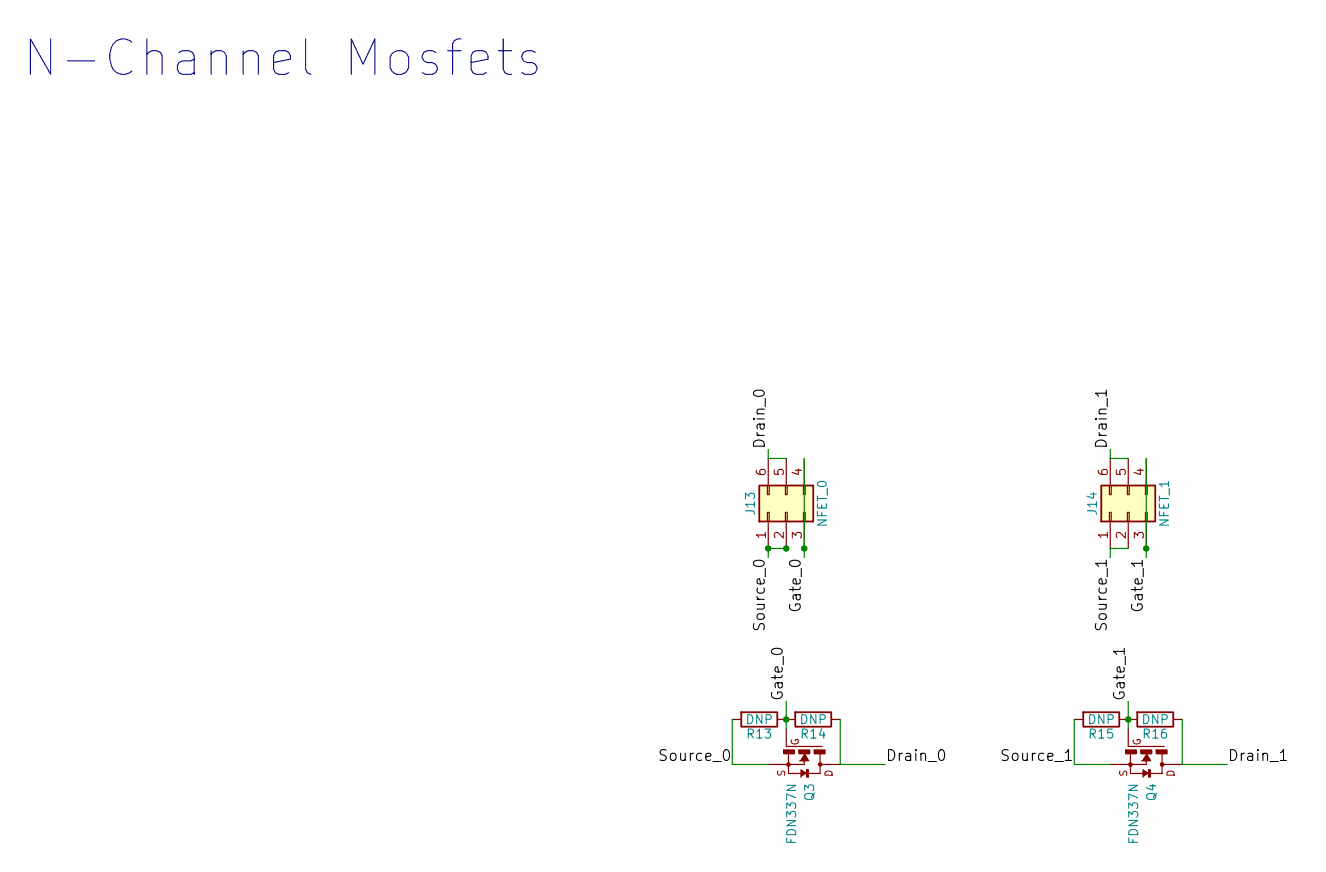
[picture p39: schematic FixtureDevKit-NMosfets.sch, Fixture-Dev-Kit]

Parts:
J13: NFET_0; Pin_Header_Straight_2x03_Pitch2.54mm
J14: NFET_1; Pin_Header_Straight_2x03_Pitch2.54mm
Q3, Q4: FDN337N; SSOT-3
R13, R14, R15, R16: DNP; R_0805_HandSoldering

Connections:
/Fixture Dev Kits - NMosfets/Drain_0: J13.5, J13.6, Q3.3 (D), R14.1
/Fixture Dev Kits - NMosfets/Drain_1: J14.5, J14.6, Q4.3 (D), R16.1
/Fixture Dev Kits - NMosfets/Gate_0: J13.3, J13.4, Q3.1 (G), R13.1, R14.2
/Fixture Dev Kits - NMosfets/Gate_1: J14.3, J14.4, Q4.1 (G), R15.1, R16.2
/Fixture Dev Kits - NMosfets/Source_0: J13.1, J13.2, Q3.2 (S), R13.2
/Fixture Dev Kits - NMosfets/Source_1: J14.1, J14.2, Q4.2 (S), R15.2

Notes on the sheet:
N-Channel Mosfets

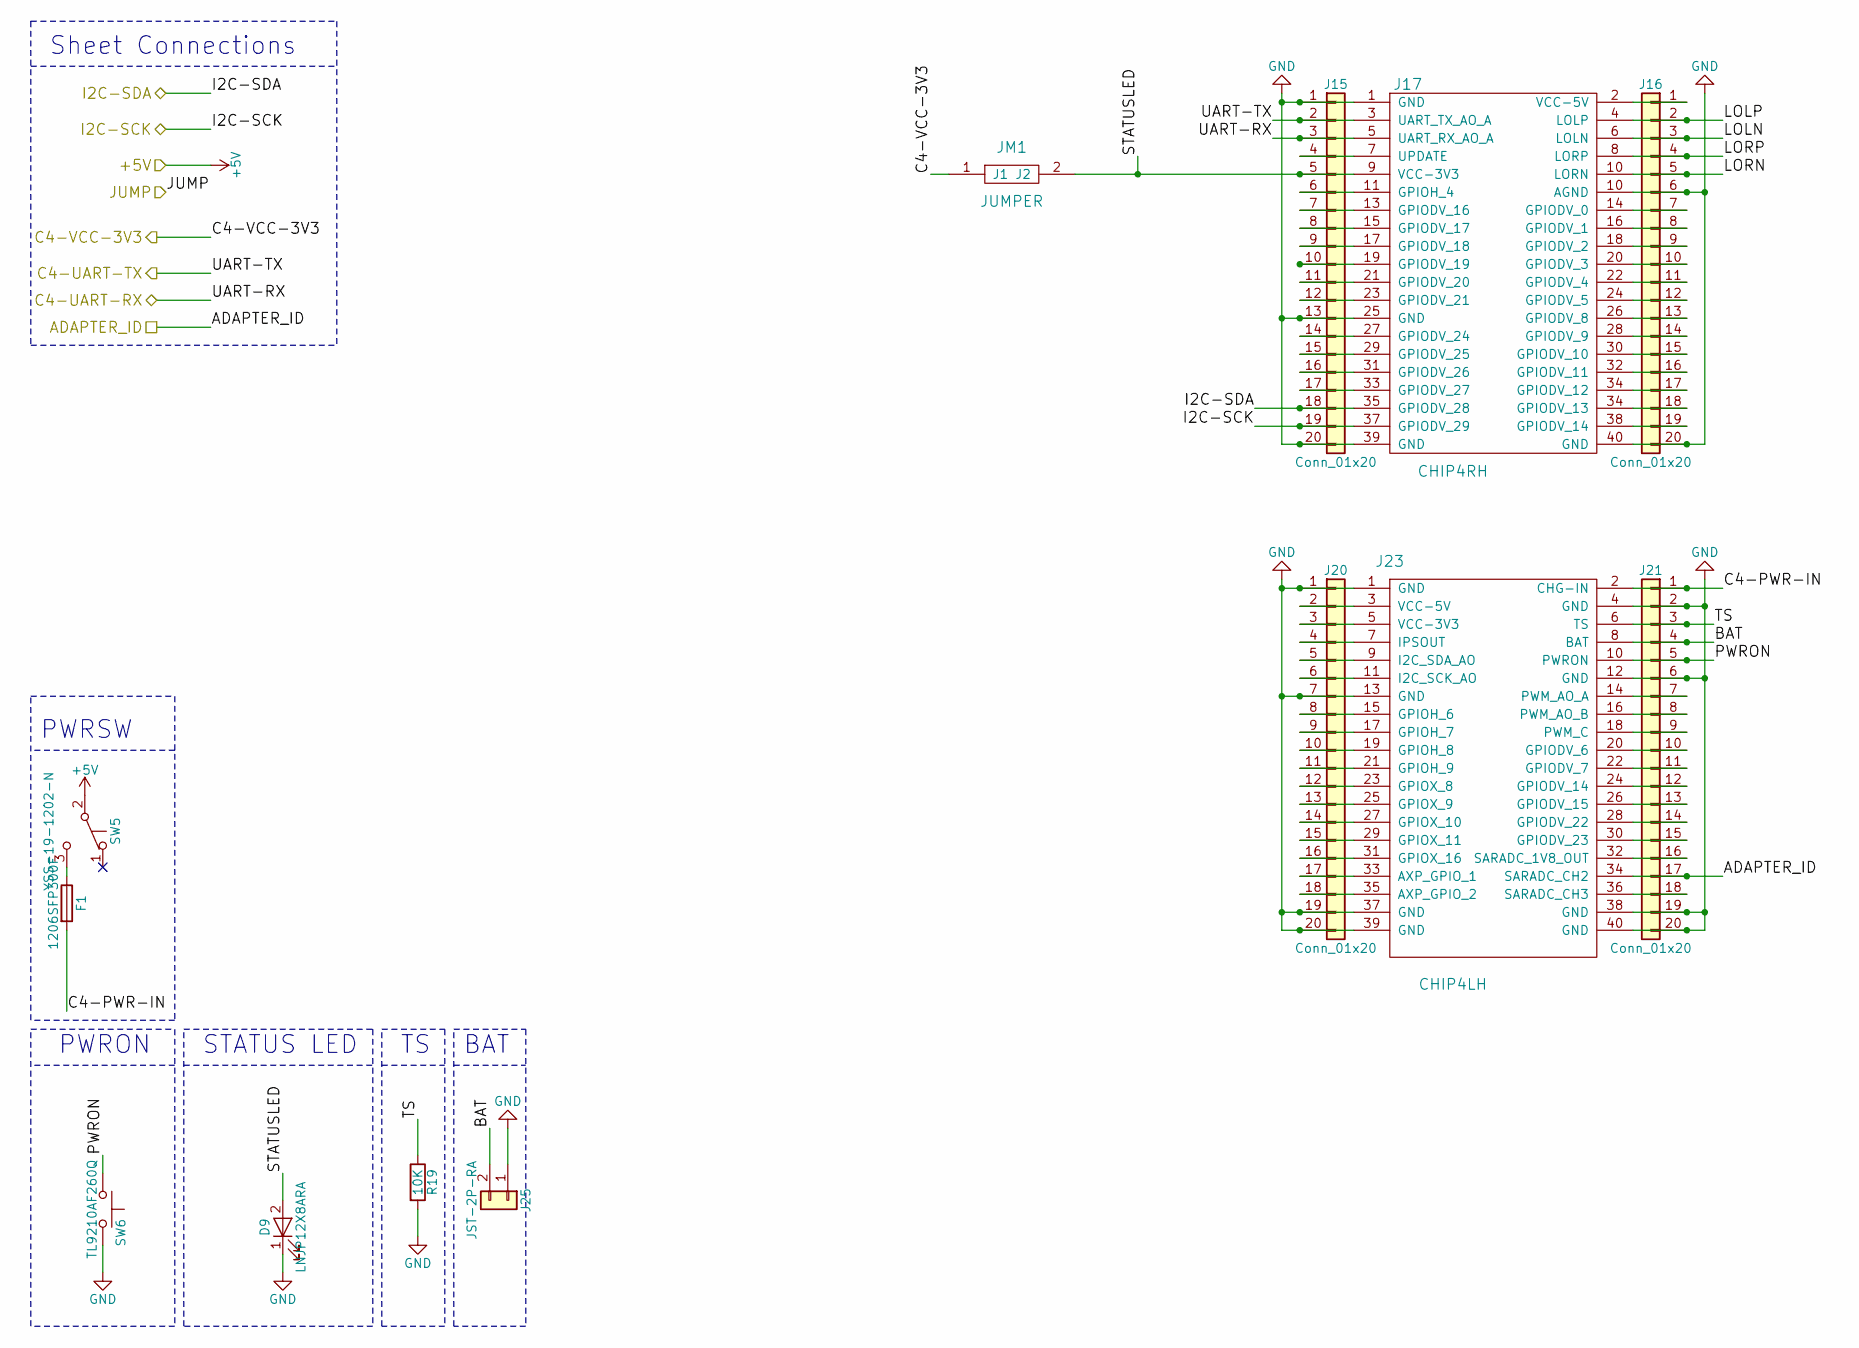
[picture p40: schematic FixtureDevKit-Functional-Computer.sch, Fixture-Dev-Kit]

Parts:
D9: LNJP12X8ARA; LED_0805_HandSoldering
F1: 1206SFP300F; 1206
J15, J16, J20, J21: Conn_01x20; Pin_Header_Straight_1x20_Pitch2.54mm
J17: CHIP4RH; Pin_Header_Straight_2x20_Pitch2.54mm
J23: CHIP4LH; Pin_Header_Straight_2x20_Pitch2.54mm
J25: JST-2P-RA; JST_PH_S2B-PH-K_02x2.00mm_Angled
JM1: JUMPER; Jumper
R19: 10K; R_0805_HandSoldering
SW5: YSS-19-1202-N
SW6: TL9210AF260Q

Connections:
+5V: SW5.2 (B); also elsewhere on the board
/ADAPTER_ID: J21.17, J23.34 (SARADC_CH2); also elsewhere on the board
/C4-VCC-3V3: JM1.1 (J1); also elsewhere on the board
/Fixture Dev Kit - Functional Computer/BAT: J21.4, J23.8 (BAT), J25.2
/Fixture Dev Kit - Functional Computer/C4-PWR-IN: F1.2, J21.1, J23.2 (CHG-IN)
/Fixture Dev Kit - Functional Computer/I2C-SCK: J15.19, J17.37 (GPIODV_29)
/Fixture Dev Kit - Functional Computer/I2C-SDA: J15.18, J17.35 (GPIODV_28)
/Fixture Dev Kit - Functional Computer/LOLN: J16.3, J17.6 (LOLN)
/Fixture Dev Kit - Functional Computer/LOLP: J16.2, J17.4 (LOLP)
/Fixture Dev Kit - Functional Computer/LORP: J16.4, J17.8 (LORP)
/Fixture Dev Kit - Functional Computer/PWRON: J21.5, J23.10 (PWRON), SW6.1
/Fixture Dev Kit - Functional Computer/STATUSLED: D9.2 (A), J15.5, J17.9 (VCC-3V3), JM1.2 (J2)
/Fixture Dev Kit - Functional Computer/TS: J21.3, J23.6 (TS), R19.1
/UART-RX: J15.3, J17.5 (UART_RX_AO_A); also elsewhere on the board
/UART-TX: J15.2, J17.3 (UART_TX_AO_A); also elsewhere on the board
unnamed: F1.1, SW5.3 (C)
unnamed: J15.4, J17.7 (UPDATE)
unnamed: J15.6, J17.11 (GPIOH_4)
unnamed: J15.7, J17.13 (GPIODV_16)
unnamed: J15.8, J17.15 (GPIODV_17)
unnamed: J15.9, J17.17 (GPIODV_18)
unnamed: J15.10, J17.19 (GPIODV_19)
unnamed: J15.11, J17.21 (GPIODV_20)
unnamed: J15.12, J17.23 (GPIODV_21)
unnamed: J15.14, J17.27 (GPIODV_24)
unnamed: J15.15, J17.29 (GPIODV_25)
unnamed: J15.16, J17.31 (GPIODV_26)
unnamed: J15.17, J17.33 (GPIODV_27)
unnamed: J16.1, J17.2 (VCC-5V)
unnamed: J16.7, J17.14 (GPIODV_0)
unnamed: J16.8, J17.16 (GPIODV_1)
unnamed: J16.9, J17.18 (GPIODV_2)
unnamed: J16.10, J17.20 (GPIODV_3)
unnamed: J16.11, J17.22 (GPIODV_4)
unnamed: J16.12, J17.24 (GPIODV_5)
unnamed: J16.13, J17.26 (GPIODV_8)
unnamed: J16.14, J17.28 (GPIODV_9)
unnamed: J16.15, J17.30 (GPIODV_10)
unnamed: J16.16, J17.32 (GPIODV_11)
unnamed: J16.19, J17.38 (GPIODV_14)
unnamed: J20.2, J23.3 (VCC-5V)
unnamed: J20.3, J23.5 (VCC-3V3)
unnamed: J20.4, J23.7 (IPSOUT)
unnamed: J20.5, J23.9 (I2C_SDA_AO)
unnamed: J20.6, J23.11 (I2C_SCK_AO)
unnamed: J20.8, J23.15 (GPIOH_6)
unnamed: J20.9, J23.17 (GPIOH_7)
unnamed: J20.10, J23.19 (GPIOH_8)
unnamed: J20.11, J23.21 (GPIOH_9)
unnamed: J20.12, J23.23 (GPIOX_8)
unnamed: J20.13, J23.25 (GPIOX_9)
unnamed: J20.14, J23.27 (GPIOX_10)
unnamed: J20.15, J23.29 (GPIOX_11)
unnamed: J20.16, J23.31 (GPIOX_16)
unnamed: J20.17, J23.33 (AXP_GPIO_1)
unnamed: J20.18, J23.35 (AXP_GPIO_2)
unnamed: J21.7, J23.14 (PWM_AO_A)
unnamed: J21.8, J23.16 (PWM_AO_B)
unnamed: J21.9, J23.18 (PWM_C)
unnamed: J21.10, J23.20 (GPIODV_6)
unnamed: J21.11, J23.22 (GPIODV_7)
unnamed: J21.12, J23.24 (GPIODV_14)
unnamed: J21.13, J23.26 (GPIODV_15)
unnamed: J21.14, J23.28 (GPIODV_22)
unnamed: J21.15, J23.30 (GPIODV_23)
unnamed: J21.16, J23.32 (SARADC_1V8_OUT)
unnamed: J21.18, J23.36 (SARADC_CH3)

Notes on the sheet:
STATUS LED
PWRON
BAT
Sheet Connections
PWRSW

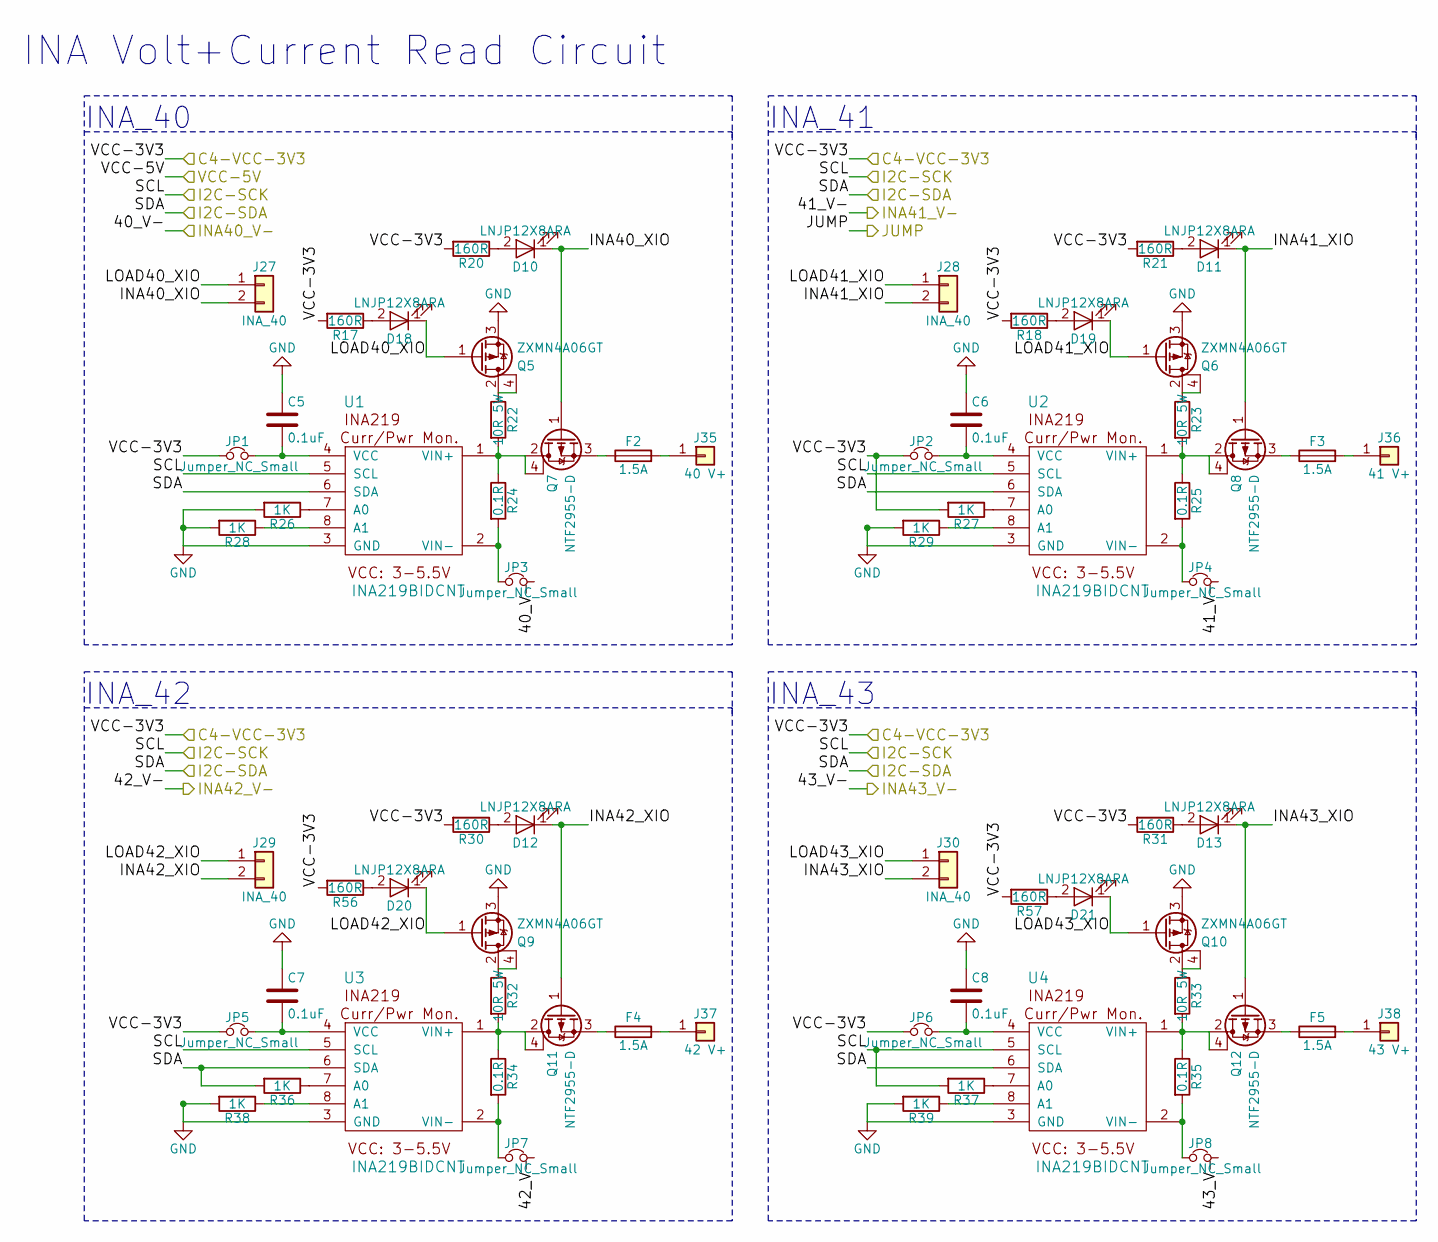
[picture p41: schematic FixtureDevKit-INA.sch, Fixture-Dev-Kit]

Parts:
C5, C6, C7, C8: 0.1uF; C_0805_HandSoldering
D10, D11, D12, D13, D18, D19, D20, D21: LNJP12X8ARA; 1206
F2, F3, F4, F5: 1.5A; 1206
J27, J28, J29, J30: INA_40; Pin_Header_Straight_1x02_Pitch2.54mm
J35: 40 V+; Pin_Header_Straight_1x01_Pitch2.54mm
J36: 41 V+; Pin_Header_Straight_1x01_Pitch2.54mm
J37: 42 V+; Pin_Header_Straight_1x01_Pitch2.54mm
J38: 43 V+; Pin_Header_Straight_1x01_Pitch2.54mm
JP1, JP2, JP3, JP4, JP5, JP6, JP7, JP8: Jumper_NC_Small; connectedCutJumper
Q5, Q6, Q9, Q10: ZXMN4A06GT; SOT230P700X180-4N
Q7, Q8, Q11, Q12: NTF2955-D; SOT230P700X180-4N
R17, R18, R20, R21, R30, R31, R56, R57: 160R; R_0805_HandSoldering
R22, R23, R32, R33: 10R 5W; RES_TWM3J560E
R24, R25, R34, R35: 0.1R; R_0805_HandSoldering
R26, R27, R28, R29, R36, R37, R38, R39: 1K; R_0805_HandSoldering
U1, U2, U3, U4: INA219BIDCNT; SOT65P280X145-8N

Connections:
/C4-VCC-3V3: JP1.1, JP2.1, JP5.1, JP6.1, R17.2, R18.2, R20.2, R21.2, R27.2, R30.2, R31.2, R56.2, R57.2; also elsewhere on the board
/Fixture Dev Kit - INA/INA40_XIO: D10.1 (K), J27.2, Q7.1 (G)
/Fixture Dev Kit - INA/INA41_XIO: D11.1 (K), J28.2, Q8.1 (G)
/Fixture Dev Kit - INA/INA42_XIO: D12.1 (K), J29.2, Q11.1 (G)
/Fixture Dev Kit - INA/INA43_XIO: D13.1 (K), J30.2, Q12.1 (G)
/Fixture Dev Kit - INA/LOAD40_XIO: D18.1 (K), J27.1, Q5.1 (G)
/Fixture Dev Kit - INA/LOAD41_XIO: D19.1 (K), J28.1, Q6.1 (G)
/Fixture Dev Kit - INA/LOAD42_XIO: D20.1 (K), J29.1, Q9.1 (G)
/Fixture Dev Kit - INA/LOAD43_XIO: D21.1 (K), J30.1, Q10.1 (G)
/I2C-SCK: R37.2, U1.5 (SCL), U2.5 (SCL), U3.5 (SCL), U4.5 (SCL); also elsewhere on the board
/I2C-SDA: R36.2, U1.6 (SDA), U2.6 (SDA), U3.6 (SDA), U4.6 (SDA); also elsewhere on the board
/INA40_V-: JP3.2; also elsewhere on the board
/INA41_V-: JP4.2; also elsewhere on the board
/INA42_V-: JP7.2; also elsewhere on the board
/INA43_V-: JP8.2; also elsewhere on the board
unnamed: C5.2, JP1.2, U1.4 (VCC)
unnamed: C6.2, JP2.2, U2.4 (VCC)
unnamed: C7.2, JP5.2, U3.4 (VCC)
unnamed: C8.2, JP6.2, U4.4 (VCC)
unnamed: D10.2 (A), R20.1
unnamed: D11.2 (A), R21.1
unnamed: D12.2 (A), R30.1
unnamed: D13.2 (A), R31.1
unnamed: D18.2 (A), R17.1
unnamed: D19.2 (A), R18.1
unnamed: D20.2 (A), R56.1
unnamed: D21.2 (A), R57.1
unnamed: F2.1, Q7.3 (S)
unnamed: F2.2, J35.1
unnamed: F3.1, Q8.3 (S)
unnamed: F3.2, J36.1
unnamed: F4.1, Q11.3 (S)
unnamed: F4.2, J37.1
unnamed: F5.1, Q12.3 (S)
unnamed: F5.2, J38.1
unnamed: JP3.1, R24.2, U1.2 (VIN-)
unnamed: JP4.1, R25.2, U2.2 (VIN-)
unnamed: JP7.1, R34.2, U3.2 (VIN-)
unnamed: JP8.1, R35.2, U4.2 (VIN-)
unnamed: Q5.2 (D), Q5.4 (D), R22.1
unnamed: Q6.2 (D), Q6.4 (D), R23.1
unnamed: Q7.2 (D), Q7.4 (D), R22.2, R24.1, U1.1 (VIN+)
unnamed: Q8.2 (D), Q8.4 (D), R23.2, R25.1, U2.1 (VIN+)
unnamed: Q9.2 (D), Q9.4 (D), R32.1
unnamed: Q10.2 (D), Q10.4 (D), R33.1
unnamed: Q11.2 (D), Q11.4 (D), R32.2, R34.1, U3.1 (VIN+)
unnamed: Q12.2 (D), Q12.4 (D), R33.2, R35.1, U4.1 (VIN+)
unnamed: R26.1, U1.7 (A0)
unnamed: R27.1, U2.7 (A0)
unnamed: R28.1, U1.8 (A1)
unnamed: R29.1, U2.8 (A1)
unnamed: R36.1, U3.7 (A0)
unnamed: R37.1, U4.7 (A0)
unnamed: R38.1, U3.8 (A1)
unnamed: R39.1, U4.8 (A1)

Notes on the sheet:
INA Volt+Current Read Circuit
INA_40
INA_41
INA_42
INA_43

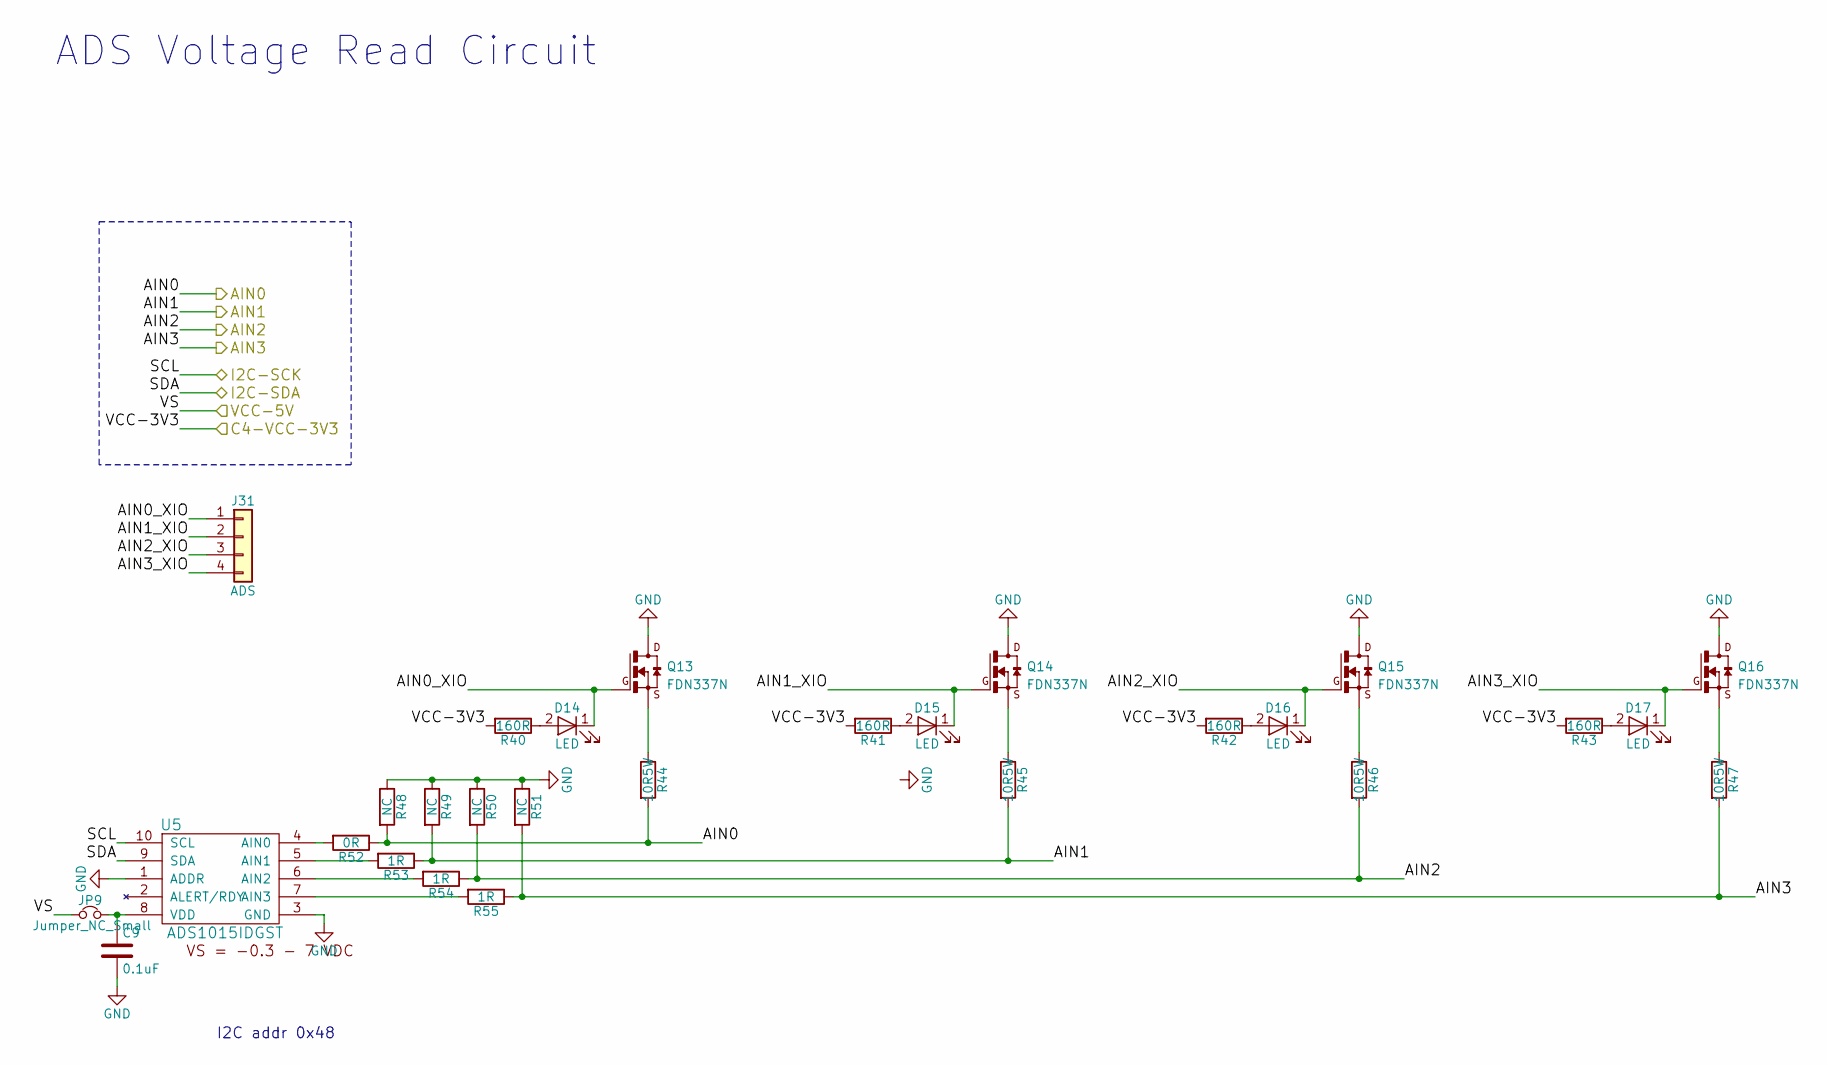
[picture p42: schematic FixtureDevKit-ADS.sch, Fixture-Dev-Kit]

Parts:
C9: 0.1uF; C_0805_HandSoldering
D14, D15, D16, D17: LED; 1206
J31: ADS; Pin_Header_Straight_1x04_Pitch2.54mm
JP9: Jumper_NC_Small; connectedCutJumper
Q13, Q14, Q15, Q16: FDN337N; SSOT-3
R40, R41, R42, R43: 160R; R_0805_HandSoldering
R44, R45, R46, R47: 10R5W; RES_TWM3J560E
R48, R49, R50, R51: NC; R_0805_HandSoldering
R52: 0R; R_0805_HandSoldering
R53, R54, R55: 1R; R_0805_HandSoldering
U5: ADS1015IDGST; SOP50P490X110-10N

Connections:
+5V: JP9.1; also elsewhere on the board
/AIN0: R44.2, R48.2, R52.1; also elsewhere on the board
/AIN1: R45.2, R49.2, R53.1; also elsewhere on the board
/AIN2: R46.2, R50.2, R54.1; also elsewhere on the board
/AIN3: R47.2, R51.2, R55.1; also elsewhere on the board
/C4-VCC-3V3: R40.2, R41.2, R42.2, R43.2; also elsewhere on the board
/Fixture Dev Kit - ADS/AIN0_XIO: D14.1 (K), J31.1, Q13.1 (G)
/Fixture Dev Kit - ADS/AIN1_XIO: D15.1 (K), J31.2, Q14.1 (G)
/Fixture Dev Kit - ADS/AIN2_XIO: D16.1 (K), J31.3, Q15.1 (G)
/Fixture Dev Kit - ADS/AIN3_XIO: D17.1 (K), J31.4, Q16.1 (G)
/I2C-SCK: U5.10 (SCL); also elsewhere on the board
/I2C-SDA: U5.9 (SDA); also elsewhere on the board
unnamed: C9.1, JP9.2, U5.8 (VDD)
unnamed: D14.2 (A), R40.1
unnamed: D15.2 (A), R41.1
unnamed: D16.2 (A), R42.1
unnamed: D17.2 (A), R43.1
unnamed: Q13.2 (S), R44.1
unnamed: Q14.2 (S), R45.1
unnamed: Q15.2 (S), R46.1
unnamed: Q16.2 (S), R47.1
unnamed: R52.2, U5.4 (AIN0)
unnamed: R53.2, U5.5 (AIN1)
unnamed: R54.2, U5.6 (AIN2)
unnamed: R55.2, U5.7 (AIN3)

Notes on the sheet:
ADS Voltage Read Circuit
I2C addr 0x48

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
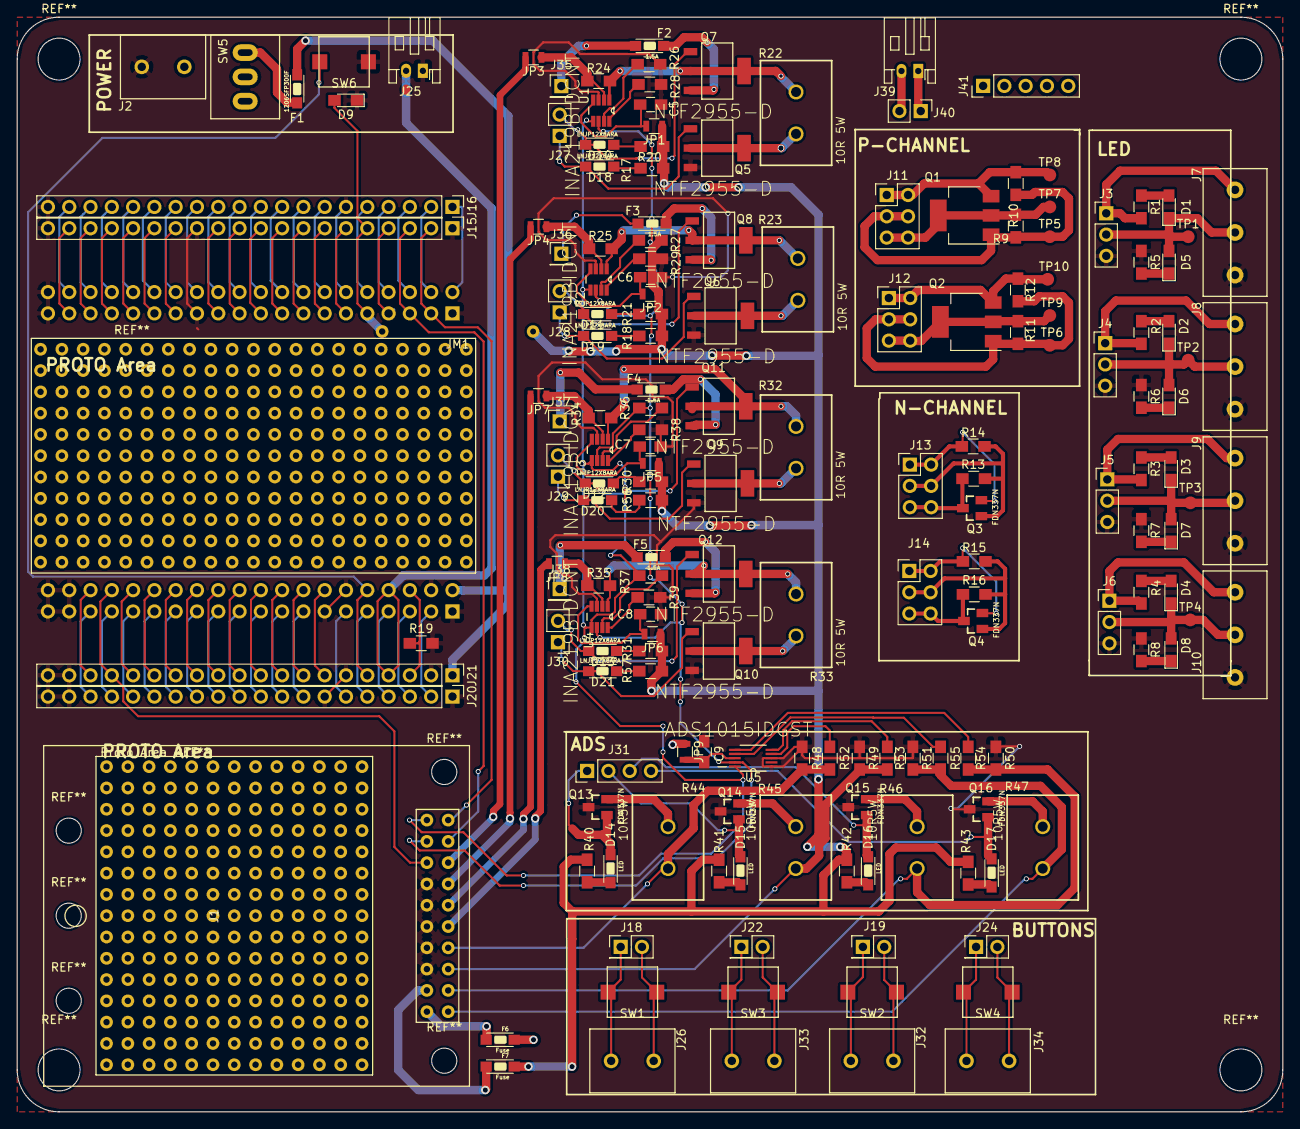
[picture p43: board Fixture-Dev-Kit.kicad_pcb from above]

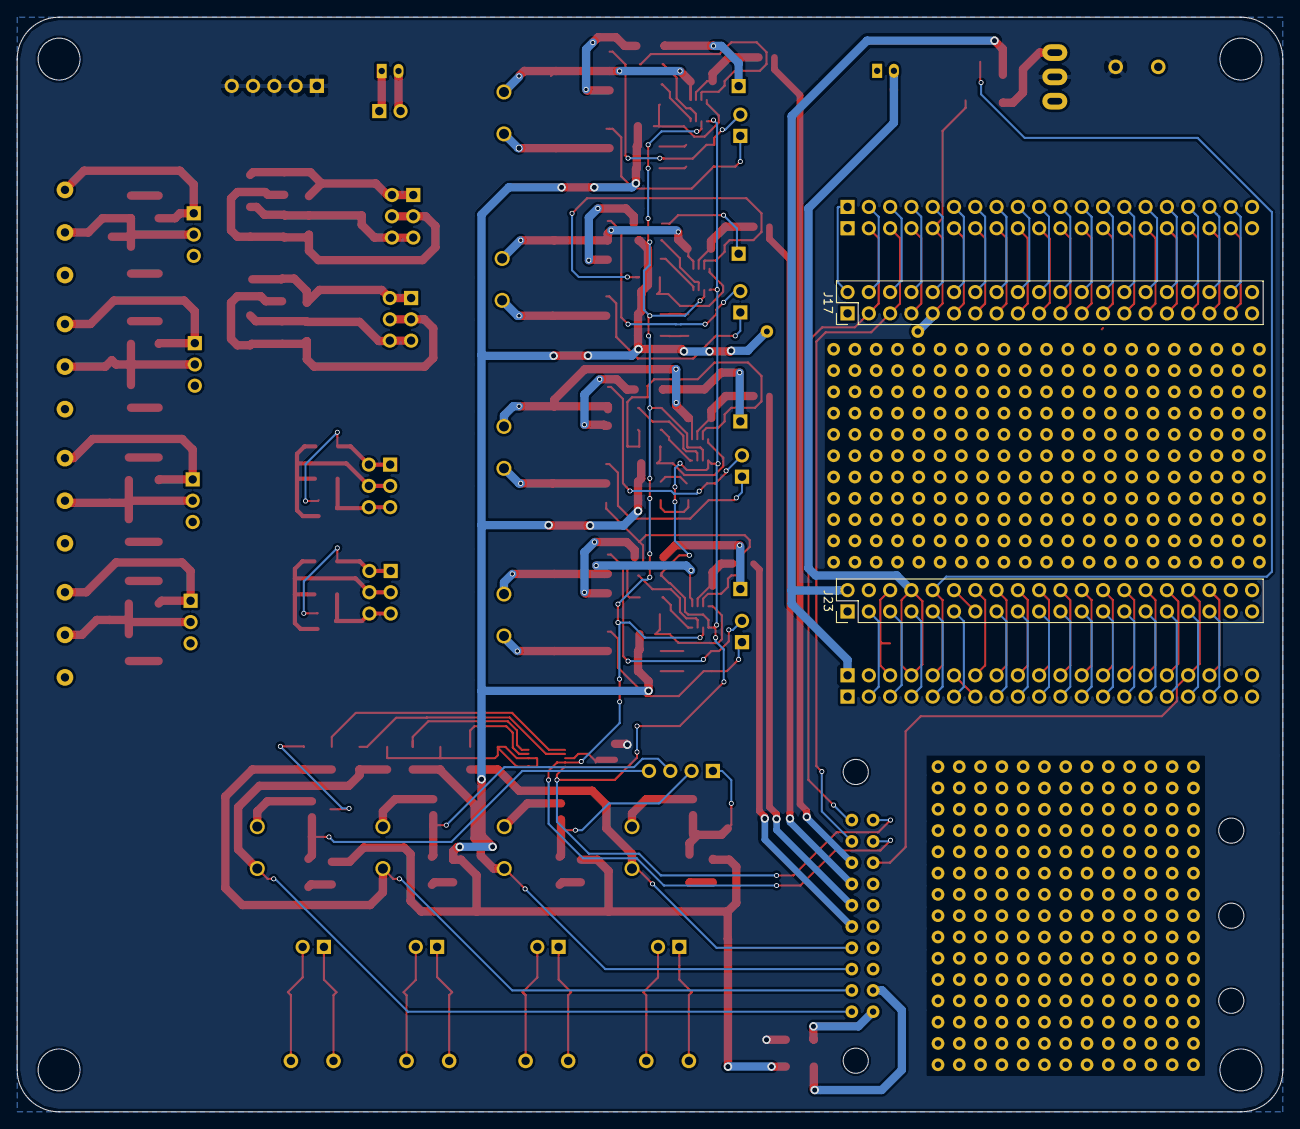
[picture p44: board Fixture-Dev-Kit.kicad_pcb from below]

Board: 2 copper layers, 151.0 x 130.6 mm, 178 parts (2 on the bottom side), 186 nets.
