puskyer/Fixture-Dev-Kit/HARDWARE/v0.05/KiCad/FixtureDevKit-Functional-Computer.sch

## KiCad design HARDWARE/v0.05/KiCad/FixtureDevKit-Functional-Computer.sch (2017-11-10)

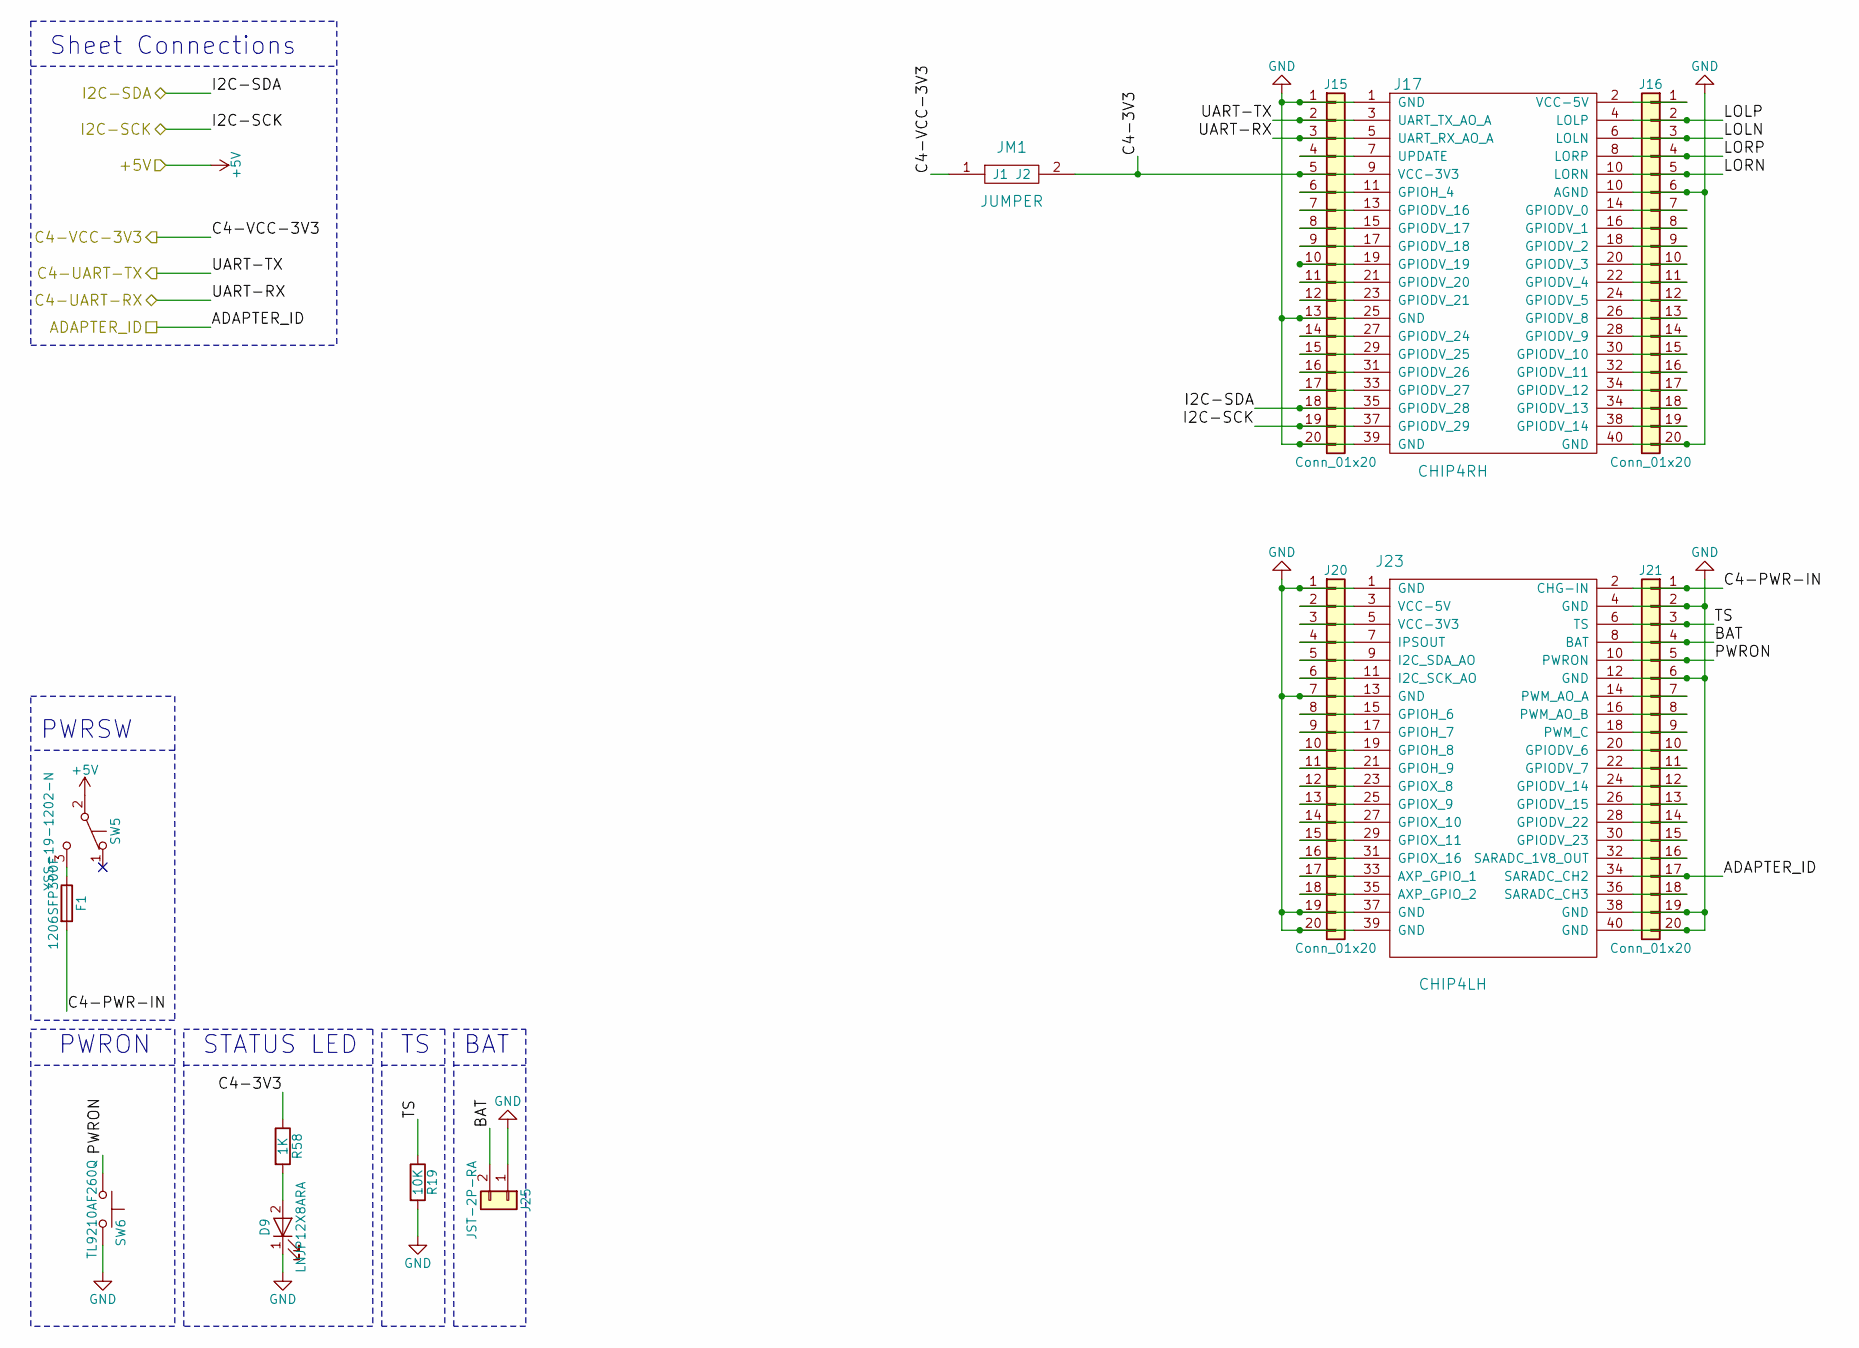
[picture p46: schematic FixtureDevKit-Functional-Computer.sch]

Parts:
D9: LNJP12X8ARA; LED_0805_HandSoldering
F1: 1206SFP300F; 1206
J15, J16, J20, J21: Conn_01x20; Pin_Header_Straight_1x20_Pitch2.54mm
J17: CHIP4RH; Pin_Header_Straight_2x20_Pitch2.54mm
J23: CHIP4LH; Pin_Header_Straight_2x20_Pitch2.54mm
J25: JST-2P-RA; JST_PH_S2B-PH-K_02x2.00mm_Angled
JM1: JUMPER; Jumper
R19: 10K; R_0805_HandSoldering
R58: 1K; R_0805_HandSoldering
SW5: YSS-19-1202-N
SW6: TL9210AF260Q

Connections:
+5V: SW5.2 (B)
ADAPTER_ID: J21.17, J23.34 (SARADC_CH2)
BAT: J21.4, J23.8 (BAT), J25.2
C4-3V3: J15.5, J17.9 (VCC-3V3), JM1.2 (J2), R58.1
C4-PWR-IN: F1.2, J21.1, J23.2 (CHG-IN)
C4-UART-RX: J15.3, J17.5 (UART_RX_AO_A)
C4-UART-TX: J15.2, J17.3 (UART_TX_AO_A)
C4-VCC-3V3: JM1.1 (J1)
GND: D9.1 (K), J15.1, J15.13, J15.20, J16.6, J16.20, J17.1 (GND), J17.10 (AGND), J17.25 (GND), J17.39 (GND), J17.40 (GND), J20.1, J20.7, J20.19, J20.20, J21.2, J21.6, J21.19, J21.20, J23.1 (GND), J23.4 (GND), J23.12 (GND), J23.13 (GND), J23.37 (GND), J23.38 (GND), J23.39 (GND), J23.40 (GND), J25.1, R19.2, SW6.2
I2C-SCK: J15.19, J17.37 (GPIODV_29)
I2C-SDA: J15.18, J17.35 (GPIODV_28)
LOLN: J16.3, J17.6 (LOLN)
LOLP: J16.2, J17.4 (LOLP)
LORN: J16.5, J17.10 (AGND)
LORP: J16.4, J17.8 (LORP)
unnamed: D9.2 (A), R58.2
unnamed: F1.1, SW5.3 (C)
unnamed: J15.4, J17.7 (UPDATE)
unnamed: J15.6, J17.11 (GPIOH_4)
unnamed: J15.7, J17.13 (GPIODV_16)
unnamed: J15.8, J17.15 (GPIODV_17)
unnamed: J15.9, J17.17 (GPIODV_18)
unnamed: J15.10, J17.19 (GPIODV_19)
unnamed: J15.11, J17.21 (GPIODV_20)
unnamed: J15.12, J17.23 (GPIODV_21)
unnamed: J15.14, J17.27 (GPIODV_24)
unnamed: J15.15, J17.29 (GPIODV_25)
unnamed: J15.16, J17.31 (GPIODV_26)
unnamed: J15.17, J17.33 (GPIODV_27)
unnamed: J16.1, J17.2 (VCC-5V)
unnamed: J16.7, J17.14 (GPIODV_0)
unnamed: J16.8, J17.16 (GPIODV_1)
unnamed: J16.9, J17.18 (GPIODV_2)
unnamed: J16.10, J17.20 (GPIODV_3)
unnamed: J16.11, J17.22 (GPIODV_4)
unnamed: J16.12, J17.24 (GPIODV_5)
unnamed: J16.13, J17.26 (GPIODV_8)
unnamed: J16.14, J17.28 (GPIODV_9)
unnamed: J16.15, J17.30 (GPIODV_10)
unnamed: J16.16, J17.32 (GPIODV_11)
unnamed: J16.17, J17.34 (GPIODV_12)
unnamed: J16.18, J17.34 (GPIODV_12)
unnamed: J16.19, J17.38 (GPIODV_14)
unnamed: J20.2, J23.3 (VCC-5V)
unnamed: J20.3, J23.5 (VCC-3V3)
unnamed: J20.4, J23.7 (IPSOUT)
unnamed: J20.5, J23.9 (I2C_SDA_AO)
unnamed: J20.6, J23.11 (I2C_SCK_AO)
unnamed: J20.8, J23.15 (GPIOH_6)
unnamed: J20.9, J23.17 (GPIOH_7)
unnamed: J20.10, J23.19 (GPIOH_8)
unnamed: J20.11, J23.21 (GPIOH_9)
unnamed: J20.12, J23.23 (GPIOX_8)
unnamed: J20.13, J23.25 (GPIOX_9)
unnamed: J20.14, J23.27 (GPIOX_10)
unnamed: J20.15, J23.29 (GPIOX_11)
unnamed: J20.16, J23.31 (GPIOX_16)
unnamed: J20.17, J23.33 (AXP_GPIO_1)
unnamed: J20.18, J23.35 (AXP_GPIO_2)
unnamed: J21.7, J23.14 (PWM_AO_A)
unnamed: J21.8, J23.16 (PWM_AO_B)
unnamed: J21.9, J23.18 (PWM_C)
unnamed: J21.10, J23.20 (GPIODV_6)
unnamed: J21.11, J23.22 (GPIODV_7)
unnamed: J21.12, J23.24 (GPIODV_14)
unnamed: J21.13, J23.26 (GPIODV_15)
unnamed: J21.14, J23.28 (GPIODV_22)
unnamed: J21.15, J23.30 (GPIODV_23)
unnamed: J21.16, J23.32 (SARADC_1V8_OUT)
unnamed: J21.18, J23.36 (SARADC_CH3)
PWRON: J21.5, J23.10 (PWRON), SW6.1
TS: J21.3, J23.6 (TS), R19.1

Notes on the sheet:
STATUS LED
PWRON
BAT
Sheet Connections
PWRSW
