puskyer/Fixture-Dev-Kit/HARDWARE/v0.05/KiCad/FixtureDevKit-INA.sch

## KiCad design HARDWARE/v0.05/KiCad/FixtureDevKit-INA.sch (2017-11-10)

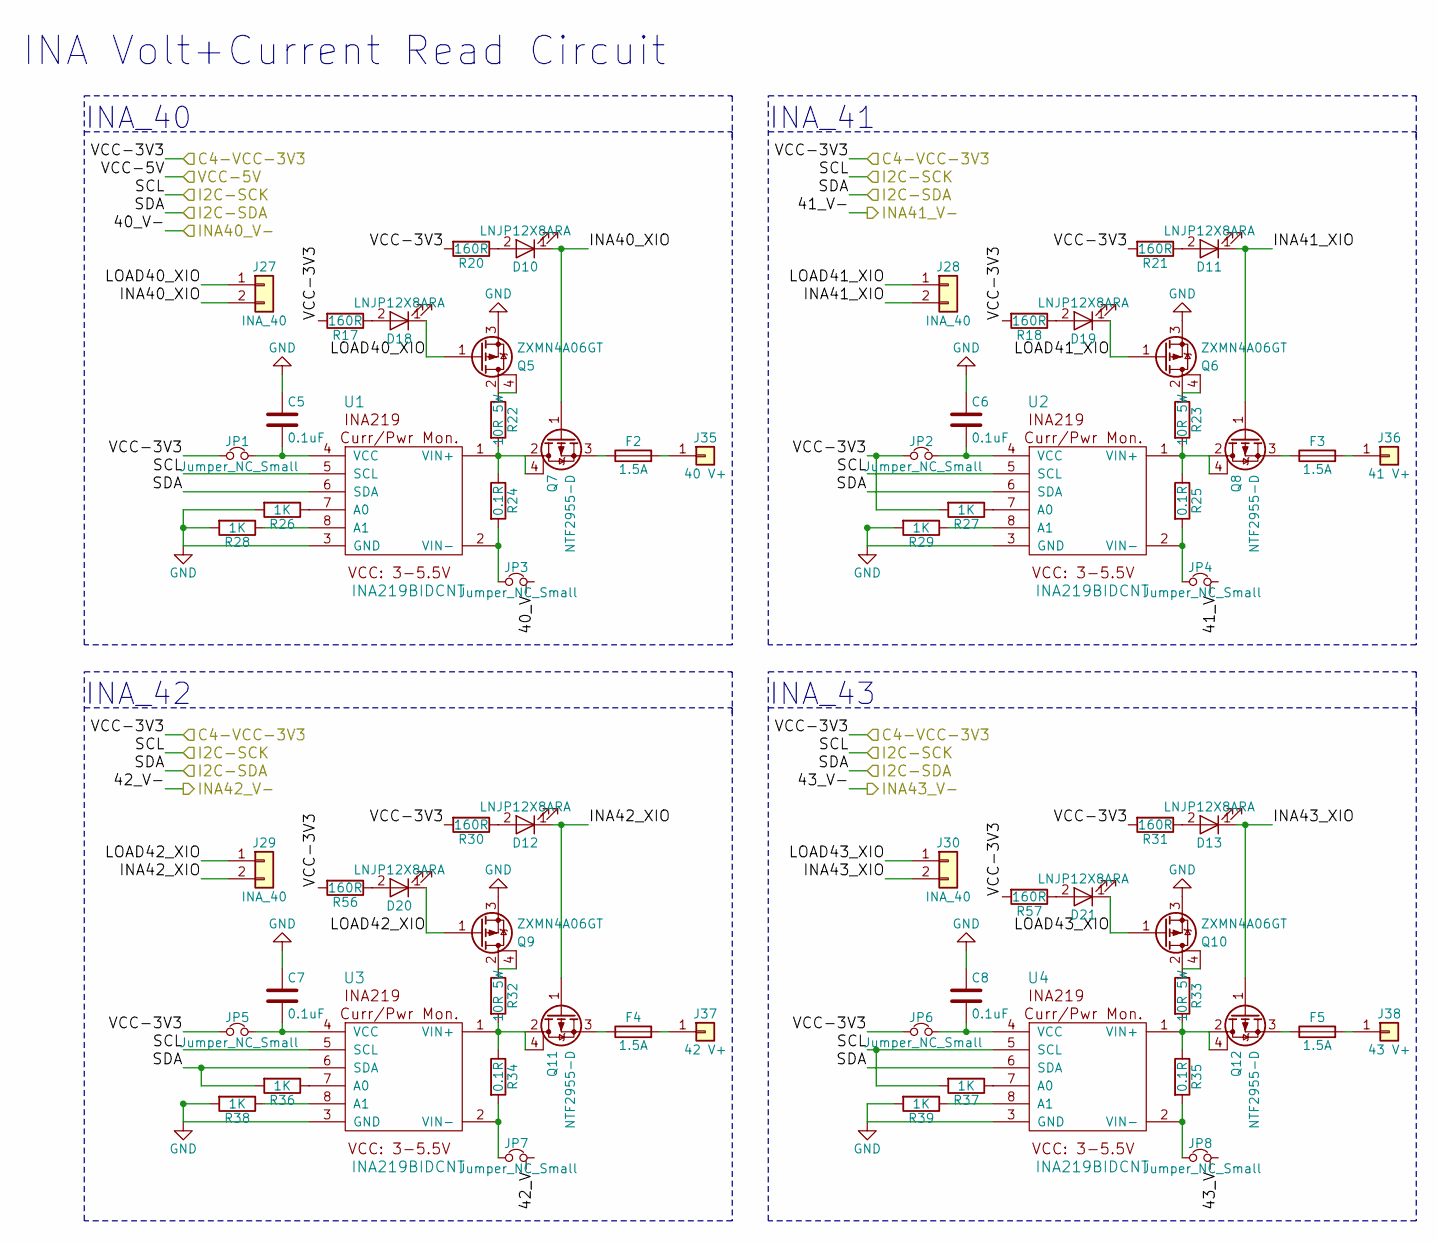
[picture p47: schematic FixtureDevKit-INA.sch]

Parts:
C5, C6, C7, C8: 0.1uF; C_0805_HandSoldering
D10, D11, D12, D13, D18, D19, D20, D21: LNJP12X8ARA; 1206
F2, F3, F4, F5: 1.5A; 1206
J27, J28, J29, J30: INA_40; Pin_Header_Straight_1x02_Pitch2.54mm
J35: 40 V+; Pin_Header_Straight_1x01_Pitch2.54mm
J36: 41 V+; Pin_Header_Straight_1x01_Pitch2.54mm
J37: 42 V+; Pin_Header_Straight_1x01_Pitch2.54mm
J38: 43 V+; Pin_Header_Straight_1x01_Pitch2.54mm
JP1, JP2, JP3, JP4, JP5, JP6, JP7, JP8: Jumper_NC_Small; connectedCutJumper
Q5, Q6, Q9, Q10: ZXMN4A06GT; SOT230P700X180-4N
Q7, Q8, Q11, Q12: NTF2955-D; SOT230P700X180-4N
R17, R18, R20, R21, R30, R31, R56, R57: 160R; R_0805_HandSoldering
R22, R23, R32, R33: 10R 5W; RES_TWM3J560E
R24, R25, R34, R35: 0.1R; R_0805_HandSoldering
R26, R27, R28, R29, R36, R37, R38, R39: 1K; R_0805_HandSoldering
U1, U2, U3, U4: INA219BIDCNT; SOT65P280X145-8N

Connections:
40_V-: JP3.2
41_V-: JP4.2
42_V-: JP7.2
43_V-: JP8.2
C4-VCC-3V3: JP1.1, JP2.1, JP5.1, JP6.1, R17.2, R18.2, R20.2, R21.2, R27.2, R30.2, R31.2, R56.2, R57.2
GND: C5.1, C6.1, C7.1, C8.1, Q5.3 (S), Q6.3 (S), Q9.3 (S), Q10.3 (S), R26.2, R28.2, R29.2, R38.2, R39.2, U1.3 (GND), U2.3 (GND), U3.3 (GND), U4.3 (GND)
I2C-SCK: R37.2, U1.5 (SCL), U2.5 (SCL), U3.5 (SCL), U4.5 (SCL)
I2C-SDA: R36.2, U1.6 (SDA), U2.6 (SDA), U3.6 (SDA), U4.6 (SDA)
INA40_XIO: D10.1 (K), J27.2, Q7.1 (G)
INA41_XIO: D11.1 (K), J28.2, Q8.1 (G)
INA42_XIO: D12.1 (K), J29.2, Q11.1 (G)
INA43_XIO: D13.1 (K), J30.2, Q12.1 (G)
LOAD40_XIO: D18.1 (K), J27.1, Q5.1 (G)
LOAD41_XIO: D19.1 (K), J28.1, Q6.1 (G)
LOAD42_XIO: D20.1 (K), J29.1, Q9.1 (G)
LOAD43_XIO: D21.1 (K), J30.1, Q10.1 (G)
unnamed: C5.2, JP1.2, U1.4 (VCC)
unnamed: C6.2, JP2.2, U2.4 (VCC)
unnamed: C7.2, JP5.2, U3.4 (VCC)
unnamed: C8.2, JP6.2, U4.4 (VCC)
unnamed: D10.2 (A), R20.1
unnamed: D11.2 (A), R21.1
unnamed: D12.2 (A), R30.1
unnamed: D13.2 (A), R31.1
unnamed: D18.2 (A), R17.1
unnamed: D19.2 (A), R18.1
unnamed: D20.2 (A), R56.1
unnamed: D21.2 (A), R57.1
unnamed: F2.1, Q7.3 (S)
unnamed: F2.2, J35.1
unnamed: F3.1, Q8.3 (S)
unnamed: F3.2, J36.1
unnamed: F4.1, Q11.3 (S)
unnamed: F4.2, J37.1
unnamed: F5.1, Q12.3 (S)
unnamed: F5.2, J38.1
unnamed: JP3.1, R24.2, U1.2 (VIN-)
unnamed: JP4.1, R25.2, U2.2 (VIN-)
unnamed: JP7.1, R34.2, U3.2 (VIN-)
unnamed: JP8.1, R35.2, U4.2 (VIN-)
unnamed: Q5.2 (D), Q5.4 (D), R22.1
unnamed: Q6.2 (D), Q6.4 (D), R23.1
unnamed: Q7.2 (D), Q7.4 (D), R22.2, R24.1, U1.1 (VIN+)
unnamed: Q8.2 (D), Q8.4 (D), R23.2, R25.1, U2.1 (VIN+)
unnamed: Q9.2 (D), Q9.4 (D), R32.1
unnamed: Q10.2 (D), Q10.4 (D), R33.1
unnamed: Q11.2 (D), Q11.4 (D), R32.2, R34.1, U3.1 (VIN+)
unnamed: Q12.2 (D), Q12.4 (D), R33.2, R35.1, U4.1 (VIN+)
unnamed: R26.1, U1.7 (A0)
unnamed: R27.1, U2.7 (A0)
unnamed: R28.1, U1.8 (A1)
unnamed: R29.1, U2.8 (A1)
unnamed: R36.1, U3.7 (A0)
unnamed: R37.1, U4.7 (A0)
unnamed: R38.1, U3.8 (A1)
unnamed: R39.1, U4.8 (A1)

Notes on the sheet:
INA Volt+Current Read Circuit
INA_40
INA_41
INA_42
INA_43
