puskyer/Fixture-Dev-Kit/(commit log)

2017-10-23 hey i am adding files to start the project!
    [Fixture-Dev-Kit.kicad_pcb, Fixture-Dev-Kit.sch, Fixture-Dev-Kit_DUT.sch]
2017-10-23 adding more to the files!
    - INA circuit
    - ADS circuit
    [Fixture-Dev-Kit.sch, Fixture-Dev-Kit_DUT.sch, FixtureDevKit-ADS.sch, FixtureDevKit-INA.sch, FixtureDevKit_Switches.sch]
2017-10-23 adding the dummy load circuit
    [Fixture-Dev-Kit.sch, Fixture-Dev-Kit_DUT.sch, FixtureDevKit-ADS.sch, FixtureDevKit-INA.sch, FixtureDevKit-Loads.sch, FixtureDevKit_Switches.sch]
2017-10-23 adding LED and Button circuit
    [Fixture-Dev-Kit.sch, Fixture-Dev-Kit_DUT.sch, FixtureDevKit-ADS.sch, FixtureDevKit-Functional-Computer.sch, FixtureDevKit-INA.sch, FixtureDevKit-Loads.sch, FixtureDevKit_Switches.sch]
2017-10-24 added read me
    [Fixture-Dev-Kit.kicad_pcb, Fixture-Dev-Kit.sch, Fixture-Dev-Kit_DUT.sch, FixtureDevKit-ADS.sch, FixtureDevKit-Functional-Computer.sch, FixtureDevKit-INA.sch, FixtureDevKit-Loads.sch, FixtureDevKit_Switches.sch]
2017-10-24 addin more circuits!
    [Fixture-Dev-Kit.sch, Fixture-Dev-Kit_DUT.sch, FixtureDevKit-ADS.sch, FixtureDevKit-Functional-Computer.sch, FixtureDevKit-INA.sch, FixtureDevKit-IOExpander.sch, FixtureDevKit-Loads.sch, FixtureDevKit-Mosfet.sch]
2017-10-24 editing some files. cleaning stuff up.
    [Fixture-Dev-Kit_DUT.sch, FixtureDevKit-ADS.sch, FixtureDevKit-INA.sch, FixtureDevKit_Switches.sch]
2017-10-24 o gosh
    [FixtureDevKit-ADS.sch, FixtureDevKit-INA.sch, FixtureDevKit-Loads.sch]
2017-10-24 o boy
    [FixtureDevKit-IOExpander.sch, FixtureDevKit-Mosfet.sch]
2017-10-24 adding netlist and design rules check
    [Fixture-Dev-Kit.sch, Fixture-Dev-Kit_DUT.sch, FixtureDevKit-ADS.sch, FixtureDevKit-Functional-Computer.sch, FixtureDevKit-INA.sch, FixtureDevKit-IOExpander.sch, FixtureDevKit-Loads.sch, FixtureDevKit-Mosfet.sch]
2017-10-25 updating a few blocks, adding test points
    [Fixture-Dev-Kit_DUT.sch, FixtureDevKit-ADS.sch, FixtureDevKit-INA.sch, FixtureDevKit-Mosfet.sch]
2017-10-25 adding some comments for Howie
    [Fixture-Dev-Kit.kicad_pcb, Fixture-Dev-Kit.sch, Fixture-Dev-Kit_DUT.sch, FixtureDevKit-ADS.sch, FixtureDevKit-Functional-Computer.sch, FixtureDevKit-INA.sch, FixtureDevKit-IOExpander.sch, FixtureDevKit-Loads.sch]
2017-10-25 updating the cover page
    [Fixture-Dev-Kit.sch, Fixture-Dev-Kit_DUT.sch, FixtureDevKit-ADS.sch, FixtureDevKit-Functional-Computer.sch, FixtureDevKit-INA.sch, FixtureDevKit-IOExpander.sch, FixtureDevKit-NMosfets.sch, FixtureDevKit-PMosfet.sch]
2017-10-25 adding labelings, hierarchy pins, and page titles
    [Fixture-Dev-Kit.sch, Fixture-Dev-Kit_DUT.sch, FixtureDevKit-ADS.sch, FixtureDevKit-Functional-Computer.sch, FixtureDevKit-INA.sch, FixtureDevKit-IOExpander.sch, FixtureDevKit-Loads.sch, FixtureDevKit-NMosfets.sch]
2017-10-25 adjusting page sizes and cleaning up schematics
    [Fixture-Dev-Kit.sch, Fixture-Dev-Kit_DUT.sch, FixtureDevKit-ADS.sch, FixtureDevKit-Functional-Computer.sch, FixtureDevKit-INA.sch, FixtureDevKit-IOExpander.sch, FixtureDevKit-Loads.sch, FixtureDevKit-NMosfets.sch]
2017-10-25 cleaning up schematic, run rules check, generate net list
    [Fixture-Dev-Kit.sch, Fixture-Dev-Kit_DUT.sch, FixtureDevKit-ADS.sch, FixtureDevKit-Functional-Computer.sch, FixtureDevKit-INA.sch, FixtureDevKit-IOExpander.sch, FixtureDevKit-Loads.sch, FixtureDevKit-NMosfets.sch]
2017-10-25 adding footprints
    [Fixture-Dev-Kit.sch, Fixture-Dev-Kit_DUT.sch, FixtureDevKit-ADS.sch, FixtureDevKit-Functional-Computer.sch, FixtureDevKit-INA.sch, FixtureDevKit-IOExpander.sch, FixtureDevKit-Loads.sch, FixtureDevKit-NMosfets.sch]
2017-10-25 adding footprints, starting layout
    [Fixture-Dev-Kit.sch, Fixture-Dev-Kit_DUT.sch, FixtureDevKit-ADS.sch, FixtureDevKit-Functional-Computer.sch, FixtureDevKit-INA.sch, FixtureDevKit-IOExpander.sch, FixtureDevKit-Loads.sch, FixtureDevKit-NMosfets.sch]
2017-10-26 updating pcb layout
    [Fixture-Dev-Kit.kicad_pcb, Fixture-Dev-Kit_DUT.sch, FixtureDevKit-NMosfets.sch]
2017-10-26 adding datasheets, cleaning up schematic
    [FixtureDevKit-Functional-Computer.sch]
2017-10-26 adding datasheets
    [Fixture-Dev-Kit_DUT.sch, FixtureDevKit_Switches.sch]
2017-10-26 beginning pcb layout
    [Fixture-Dev-Kit.kicad_pcb, Fixture-Dev-Kit_DUT.sch, FixtureDevKit-ADS.sch, FixtureDevKit-Functional-Computer.sch, FixtureDevKit-INA.sch, FixtureDevKit-IOExpander.sch, FixtureDevKit-Loads.sch, FixtureDevKit-PMosfet.sch]
2017-10-27 updaing PCB layout
2017-10-27 pcb roughly 15cm x 15cm
    [Fixture-Dev-Kit.kicad_pcb, FixtureDevKit-Functional-Computer.sch]
2017-10-27 more PCB layout
    [Fixture-Dev-Kit.kicad_pcb, Fixture-Dev-Kit_DUT.sch, FixtureDevKit-ADS.sch]
2017-10-27 adding datasheets and laying out PCB
    [Fixture-Dev-Kit.kicad_pcb, Fixture-Dev-Kit.sch, Fixture-Dev-Kit_DUT.sch, FixtureDevKit-ADS.sch, FixtureDevKit-Functional-Computer.sch, FixtureDevKit-INA.sch, FixtureDevKit-IOExpander.sch, FixtureDevKit-Loads.sch]
2017-10-31 quasi-redoing entire schematic and layout
    [Fixture-Dev-Kit.kicad_pcb, Fixture-Dev-Kit.sch, Fixture-Dev-Kit_DUT.sch, Fixture-Dev-Kit_DUTv0.02.sch, Fixture-Dev-Kitv0.02.kicad_pcb, Fixture-Dev-Kitv0.02.sch, FixtureDevKit-ADS.sch, FixtureDevKit-ADSv0.02.sch]
2017-10-31 updating layout
    [Fixture-Dev-Kit.kicad_pcb, FixtureDevKit-Functional-Computer.sch]
2017-10-31 updating rough layout
    [Fixture-Dev-Kit.kicad_pcb, FixtureDevKit-ADS.sch, FixtureDevKit-Functional-Computer.sch, FixtureDevKit-INA.sch]
2017-10-31 updading laytout
    [Fixture-Dev-Kit.kicad_pcb]
2017-10-31 updating layout footprints and board outline
    [Fixture-Dev-Kit.kicad_pcb, Fixture-Dev-Kit.sch, FixtureDevKit-ADS.sch, FixtureDevKit-Functional-Computer.sch, FixtureDevKit-INA.sch, FixtureDevKit_Switches.sch]
2017-11-01 updaing LED screw terminal foot print
    [Fixture-Dev-Kit.kicad_pcb, FixtureDevKit_Switches.sch]
2017-11-01 cleaning up folder
    [Fixture-Dev-Kit_DUTv0.02.sch, Fixture-Dev-Kitv0.02.kicad_pcb, Fixture-Dev-Kitv0.02.sch, FixtureDevKit-ADSv0.02.sch, FixtureDevKit-Functional-Computerv0.02.sch, FixtureDevKit-INAv0.02.sch, FixtureDevKit-IOExpanderv0.02.sch, FixtureDevKit-Loadsv0.02.sch]
2017-11-06 add v0.2 working PCB
    [Fixture-Dev-Kit.kicad_pcb]
2017-11-06 updaing PCB files to include first attempt at layout. this work is all being done in v0.2.
    dut footprint has been moved, D19 has been moved. Files are being prepped
    to be sent to next contractor.
    mitch
    [Fixture-Dev-Kit-B.Cu.gbr, Fixture-Dev-Kit-B.Fab.gbr, Fixture-Dev-Kit-B.Mask.gbr, Fixture-Dev-Kit-B.Paste.gbr, Fixture-Dev-Kit-B.SilkS.gbr, Fixture-Dev-Kit-Edge.Cuts.gbr, Fixture-Dev-Kit-F.Cu.gbr, Fixture-Dev-Kit-F.Fab.gbr]
2017-11-07 updating proto area
    [Fixture-Dev-Kit.kicad_pcb]
2017-11-07 adding 3v3 line up to DUT header
    [Fixture-Dev-Kit.kicad_pcb, Fixture-Dev-Kit.sch, FixtureDevKit-ADS.sch, FixtureDevKit-Functional-Computer.sch, FixtureDevKit-INA.sch, FixtureDevKit_Switches.sch]
2017-11-07 updating project name
    [Fixture-Dev-Kit.sch, FixtureDevKit-ADS.sch, FixtureDevKit-Functional-Computer.sch, FixtureDevKit-INA.sch, FixtureDevKit-NMosfets.sch, FixtureDevKit-PMosfet.sch, FixtureDevKit_Switches.sch]
2017-11-07 adding pdf of eco a, adding zip file
    [Fixture-Dev-Kit-B.Cu.gbr, Fixture-Dev-Kit-B.Fab.gbr, Fixture-Dev-Kit-B.Mask.gbr, Fixture-Dev-Kit-B.Paste.gbr, Fixture-Dev-Kit-B.SilkS.gbr, Fixture-Dev-Kit-Edge.Cuts.gbr, Fixture-Dev-Kit-F.Cu.gbr, Fixture-Dev-Kit-F.Fab.gbr]
2017-11-07 updating zip to remove Ms. Johnson's 7th Period Science Project from the title block on the schematic and replace it with Fixture-Dev-Kit
    [Fixture-Dev-Kit.sch, FixtureDevKit-ADS.sch, FixtureDevKit-Functional-Computer.sch, FixtureDevKit-INA.sch, FixtureDevKit-NMosfets.sch, FixtureDevKit-PMosfet.sch, FixtureDevKit_Switches.sch]
2017-11-07 adding folder with info for C4 daughterboard design guidelines
    [_saved_Fixture-Dev-Kit.sch, _saved_FixtureDevKit-Functional-Computer.sch]
2017-11-08 adding latest updates from pcb layout designed 11/8/2017
    [Fixture-Dev-Kit.kicad_pcb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]
2017-11-08 updaing adapter pcb mechanical guidelines
    adding ECO B for fixture dev kit layout contractor
    [Fixture-Dev-Kit.kicad_pcb]
2017-11-08 updating ECO B for PCB layout contractor
2017-11-09 updating C4 Functional computer footprint, creating compressed folder
    [Fixture-Dev-Kit.kicad_pcb]
2017-11-09 add 11/9 Ajay WIP edits for v0.03
    [Fixture-Dev-Kit.kicad_pcb, Fixture-Dev-Kit.sch, Fixture-Dev-Kit_DUT.sch, FixtureDevKit-ADS.sch, FixtureDevKit-Functional-Computer.sch, FixtureDevKit-INA.sch, FixtureDevKit-IOExpander.sch, FixtureDevKit-Loads.sch]
2017-11-09 add 11/9/17 version 0.03
    [Fixture-Dev-Kit.kicad_pcb, Fixture-Dev-Kit.sch, Fixture-Dev-Kit_DUT.sch, FixtureDevKit-ADS.sch, FixtureDevKit-Functional-Computer.sch, FixtureDevKit-INA.sch, FixtureDevKit-IOExpander.sch, FixtureDevKit-Loads.sch]
2017-11-10 add v0.05 from Ajay
    [Fixture-Dev-Kit-B.Cu.gbl, Fixture-Dev-Kit-Dwgs.User.gbr, Fixture-Dev-Kit-Edge.Cuts.gm1, Fixture-Dev-Kit-F.Cu.gtl, Fixture-Dev-Kit-F.Mask.gts, Fixture-Dev-Kit-F.Paste.gtp, Fixture-Dev-Kit-F.SilkS.gto, Fixture-Dev-Kit.drl]
2017-11-10 adding moset notes pdf
    [Fixture-Dev-Kit.kicad_pcb, Fixture-Dev-Kit.sch, Fixture-Dev-Kit_DUT.sch, FixtureDevKit-ADS.sch, FixtureDevKit-Functional-Computer.sch, FixtureDevKit-INA.sch, FixtureDevKit-IOExpander.sch, FixtureDevKit-Loads.sch]
2017-11-10 adding files for C4 pcb adapter board for fixture-dev-kit
    [Fixture-Dev-Kit-C4-Adapater-Board.SLDDRW, Fixture-Dev-Kit-C4-Adapater-Board.SLDPRT]
2017-11-10 adding photos for mosfet circuit notes
2017-11-10 adding files ffor the C4 adapter board dev kit
    updating N-Channel labeling on INA circuits
    [CHIP4-DUT-Adapter-PCB.kicad_pcb, CHIP4-DUT-Adapter-PCB.sch, FixtureDevKit-Functional-Computer.sch, FixtureDevKit-INA.sch]
2017-11-10 updaing files, audio jack circuit
    [CHIP4-DUT-Adapter-PCB.kicad_pcb, CHIP4-DUT-Adapter-PCB.sch, Fixture-Dev-Kit-C4-Adapater-Board.SLDDRW, Fixture-Dev-Kit-C4-Adapater-Board.SLDPRT]
2017-11-10 updating to latest
    [CHIP4-DUT-Adapter-PCB.sch]
2017-11-21 add adapter boards, check J1 pinout
    [CHIP4 DUT Adapter Board.brd, CHIP4 DUT Adapter Board.sch, CHIP4-DUT-Adapter-PCB.kicad_pcb, CHIP4-DUT-Adapter-PCB.sch, Fixture-Dev-Kit-C4-Adapater-Board.kicad_pcb, Fixture-Dev-Kit-C4-Adapater-Board.sch, PUQFN-N32_5mmX5mm_P0.5.step]
